RiceAllDay22/WirelessSensorNetwork/README.md

# Introduction to the Wireless Sensor Network Project
This repository contains the files utilized to create a low-cost wireless sensor network to identify, locate, and quantify CO2 sources within an area. The primary component of the network is the CO2 Sensor Node, for which there are two variants: the Arduino Version and the XBee Version. 

Both variants have the same essential function of collecting CO2 and wind data. The difference, however, is that the Arduino Version stores data within a microSD card, while the XBee Version sends data to a central hub. The XBee Version is the prominent hardware of this project.

An external repository called the [CSR_Arduino_Collection](https://github.com/RiceAllDay22/CSR_Arduino_Collection) is a complementary project that contains guides, codes, schematics, and datasheets for operating various sensors and modules, including the ones used in WSN. 

The overall WSN project is divided into three sections. [Section 1](https://github.com/RiceAllDay22/WirelessSensorNetwork/tree/master/Section1-Prototyping) focuses on the development of the Sensor Nodes. Next, [Section 2](https://github.com/RiceAllDay22/WirelessSensorNetwork/tree/master/Section2-Networking) establishes a wireless network between active nodes. Finally, [Section 3](https://github.com/RiceAllDay22/WirelessSensorNetwork/tree/master/Section3-Detecting) uses the collected data to identify and locate possible CO2 sources. Below are summaries and highlights of each section. 

# [Section 1: Developing the Sensor Nodes](https://github.com/RiceAllDay22/WirelessSensorNetwork/tree/master/Section1-Prototyping)
The Sensor Nodes are the backbone of WSN. Although there are two different variants: the Arduino Version and the XBee Version, they all consist of a CO2 sensor, a wind anemometer, and a time-keeping module.

[Arduino Version](https://github.com/jkub6/WirelessSensorNetwork/tree/master/Section1-ArduinoVersion) 
- Microcontroller is Arduino Nano
- Data saved on to a local microSD card
- Hardware is built on a solderless breadboard
- Code is compiled using Arduino IDE <br>

[XBee Version](https://github.com/jkub6/WirelessSensorNetwork/tree/master/Section2-XBeeVersion)
- Microcontroller is Digi XBee3
- Data transmitted to central hub
- Hardware is assembled on a custom printed-cicuit board
- Code is compiled using PyCharm

## Overview of Sensor Node
- [Arduino Version](https://github.com/RiceAllDay22/WirelessSensorNetwork/tree/master/Section1-Prototyping/SensorNode-ArduinoVersion)
- [XBee Version](https://github.com/RiceAllDay22/WirelessSensorNetwork/tree/master/Section1-Prototyping/SensorNode-XBeeVersion)

## Assessments of Individual Components
- [CU1106 CO2 Sensor](https://github.com/RiceAllDay22/WirelessSensorNetwork/tree/master/Section1-Prototyping/Assessment-CU1106) (not used for in current Node iterations)
- [SCD30 CO2 Sensor](https://github.com/RiceAllDay22/WirelessSensorNetwork/tree/master/Section1-Prototyping/Assessment-SCD30) (currently implemented in both Node versions)
- [DS3231 Timekeeping Module](https://github.com/RiceAllDay22/WirelessSensorNetwork/tree/master/Section1-Prototyping/Assessment-DS3231) (currently implemented in both Node versions)

## Power Evaluations
- [Power Usage of Nodes](https://github.com/RiceAllDay22/WirelessSensorNetwork/tree/master/Section1-Prototyping/Evaluation-PowerUsage)
- [Solar Requirement](https://github.com/RiceAllDay22/WirelessSensorNetwork/tree/master/Section1-Prototyping/Evaluation-PowerUsage)

# [Section 2: Establishing the Network](https://github.com/RiceAllDay22/WirelessSensorNetwork/tree/master/Section2-Networking)

The board is designed using Autodesk Eagle.

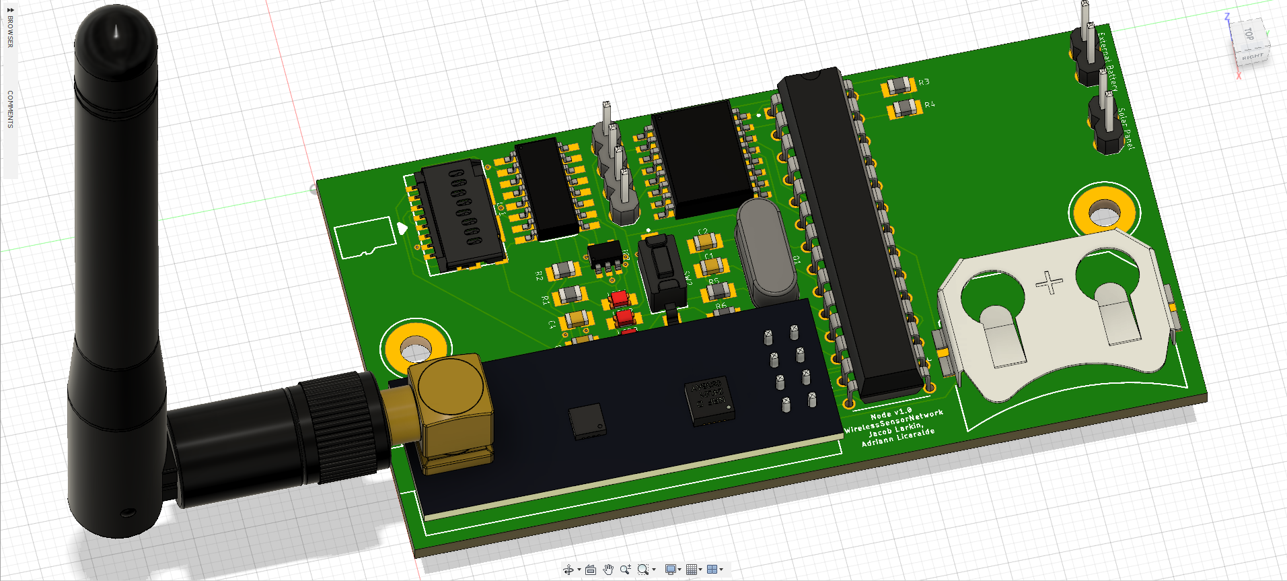
[picture p1: Collection/Node/Hardware/Node_step.png]
Node step
  
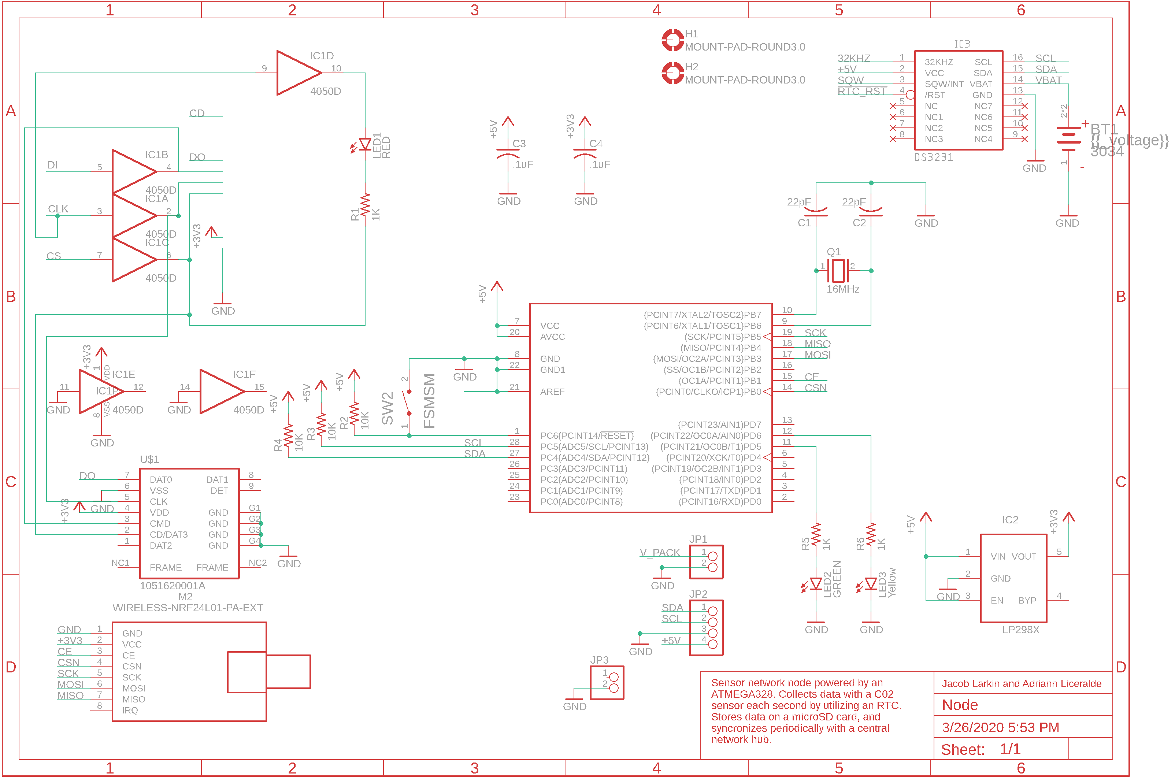
[picture p2: Collection/Node/Hardware/Node_sch.png]
Node schematic
  
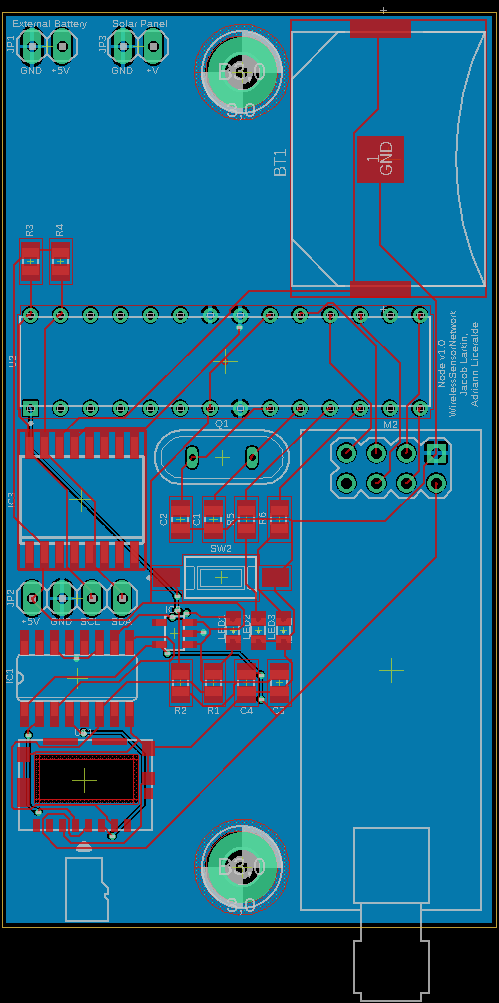
[picture p3: Collection/Node/Hardware/Node_brd.png]
Node board
  

# [Section 3: Locating Possible Carbon Sources](https://github.com/RiceAllDay22/WirelessSensorNetwork/tree/master/Section3-Detecting)
## Node Software
Code controlling individual nodes is compiled through the Arduino IDE.

Arduino Library Requirments:
 - RTClib
 - SdFat

resources:
[One Drive Resources Folder](https://uofutah-my.sharepoint.com/:f:/g/personal/u1010401_umail_utah_edu/Ekx1kX9h63tNoVFmzbePeowB8LEIOgGHBQhFq369KU12vQ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)

# Copyright and Contributors
Every hardware and every code in WirelessSensorNetwork and CSR_Arduino_Collection is given the Creative Commons License and the MIT License, respectively. Any content in the repository can be used and changed freely. The only requirement is that the original [license notice](https://github.com/jkub6/WirelessSensorNetwork/blob/master/LICENSE.md) is included in any copy of the software. 

The WirelessSensorNetwork project and the CSR_Arduino_Collection project are led by Adriann Liceralde under the leadership of Dr. Brian McPherson from the Carbon Science Research group at the University of Utah. Any questions, comments, or concerns are welcome to be sent to adriann8399@gmail.com.

Notable contributors to the project are Jacob Larkin, Charlie Leo, Tessa Bailey, Sean Taplin, and Andrew Winkelmann.

(c) Copyright 2022 Jacob Larkin and Adriann Liceralde
