RiceAllDay22/WirelessSensorNetwork/Data/ContinuousNodeSampling/V All/Report/PrimaryNode.png

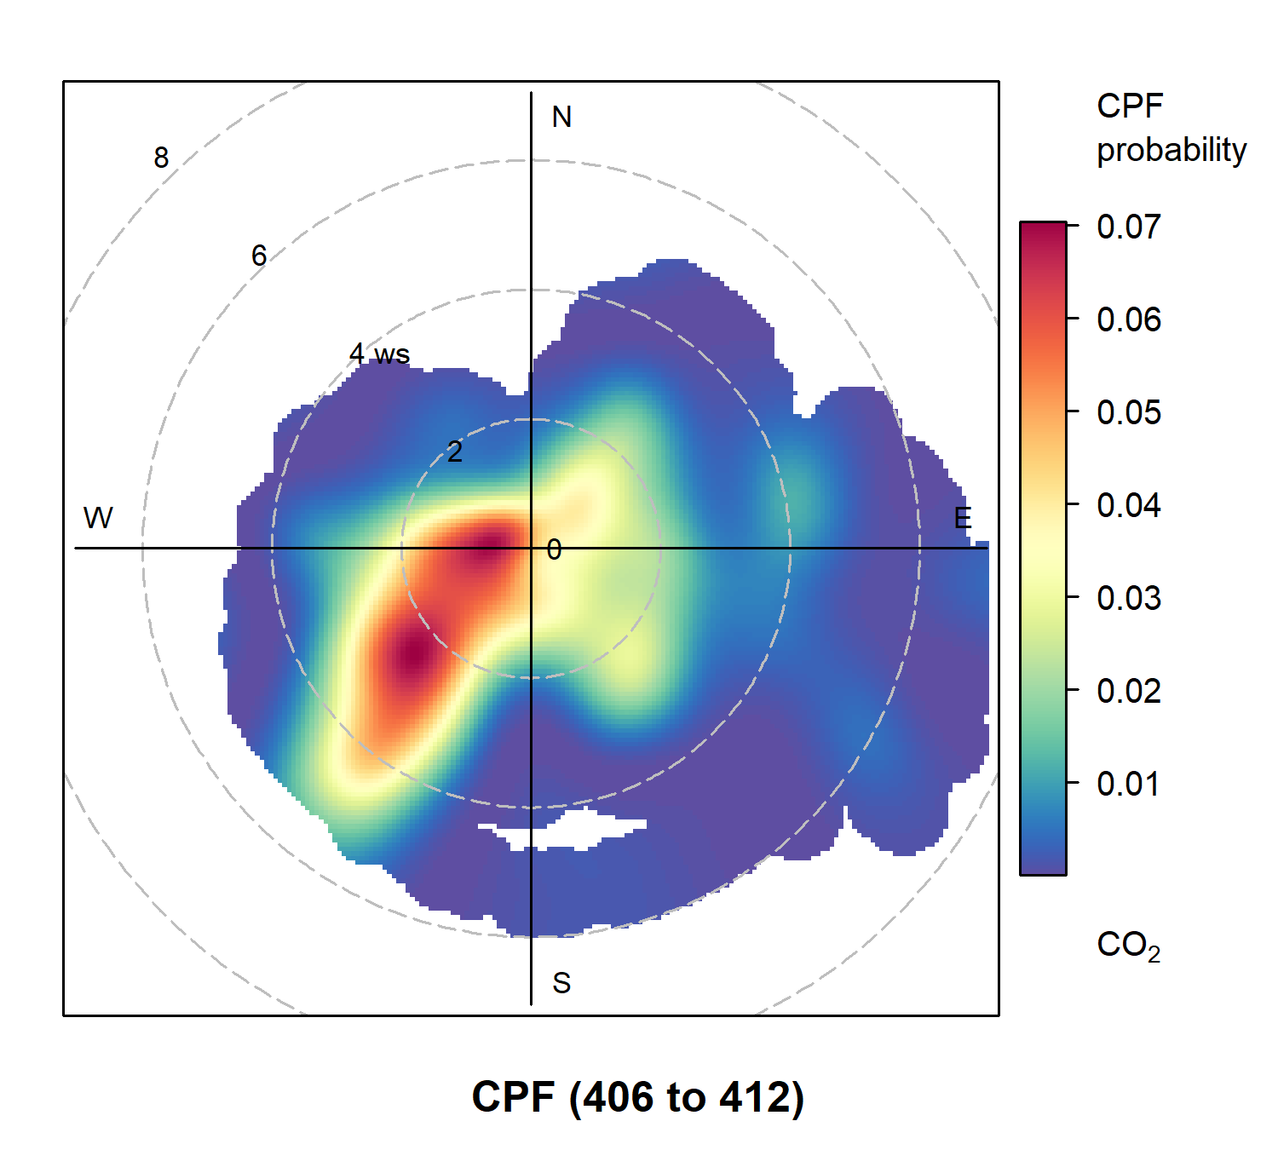
Data/ContinuousNodeSampling/V All/Report/PrimaryNode.png
