RiceAllDay22/WirelessSensorNetwork/Data/ContinuousNodeSampling/V All/Report/PrimaryNodeAdjusted.png

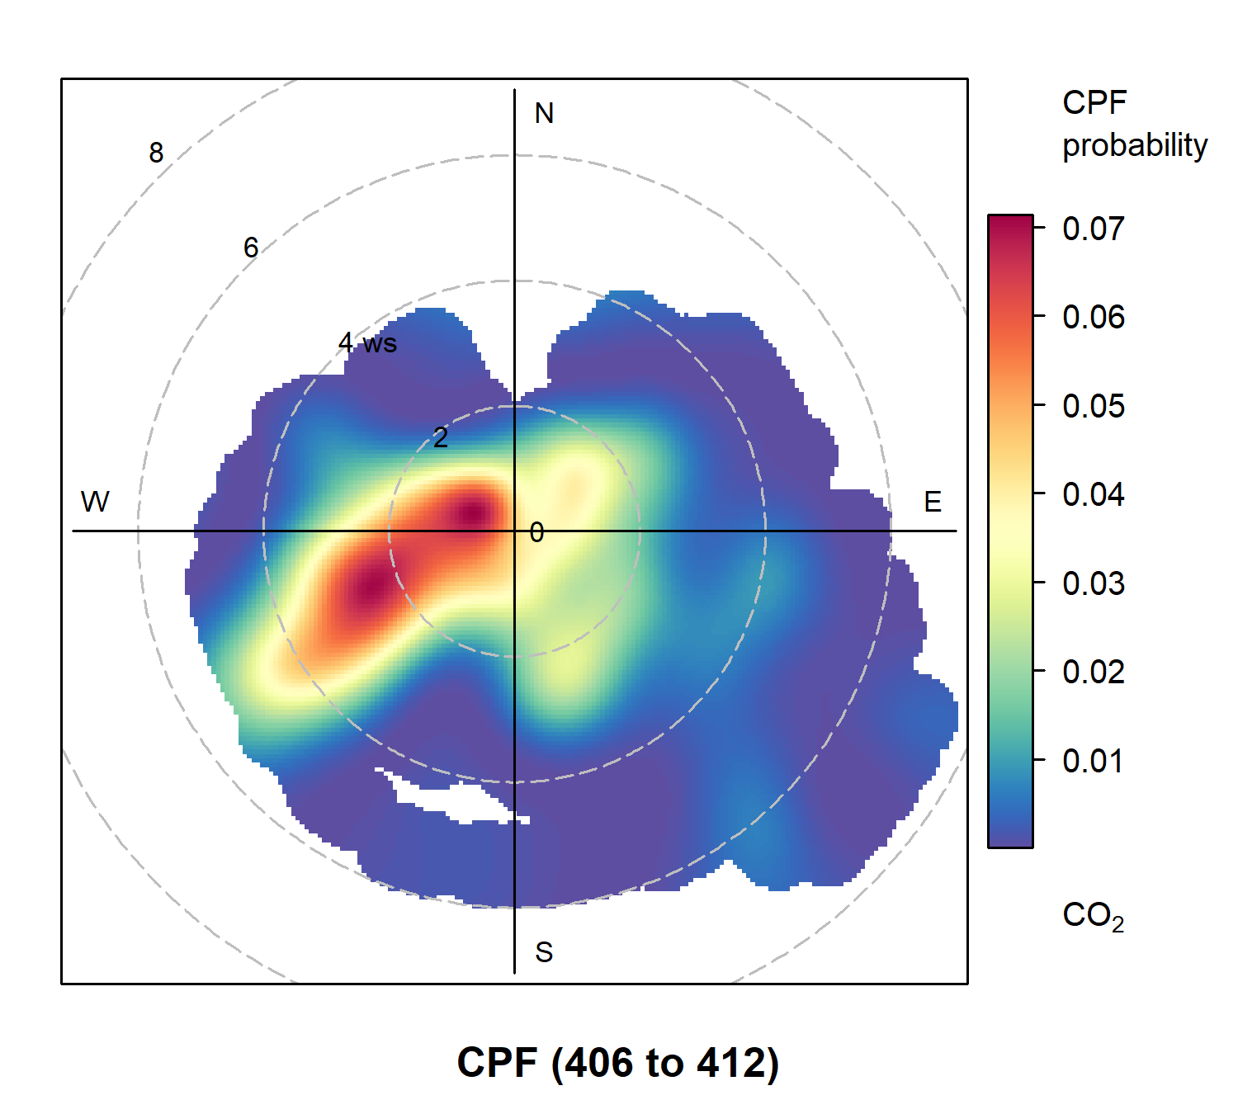
Data/ContinuousNodeSampling/V All/Report/PrimaryNodeAdjusted.png
