RiceAllDay22/WirelessSensorNetwork/Data/ContinuousNodeSampling/V All/Report/SecondaryNodeFirst.png

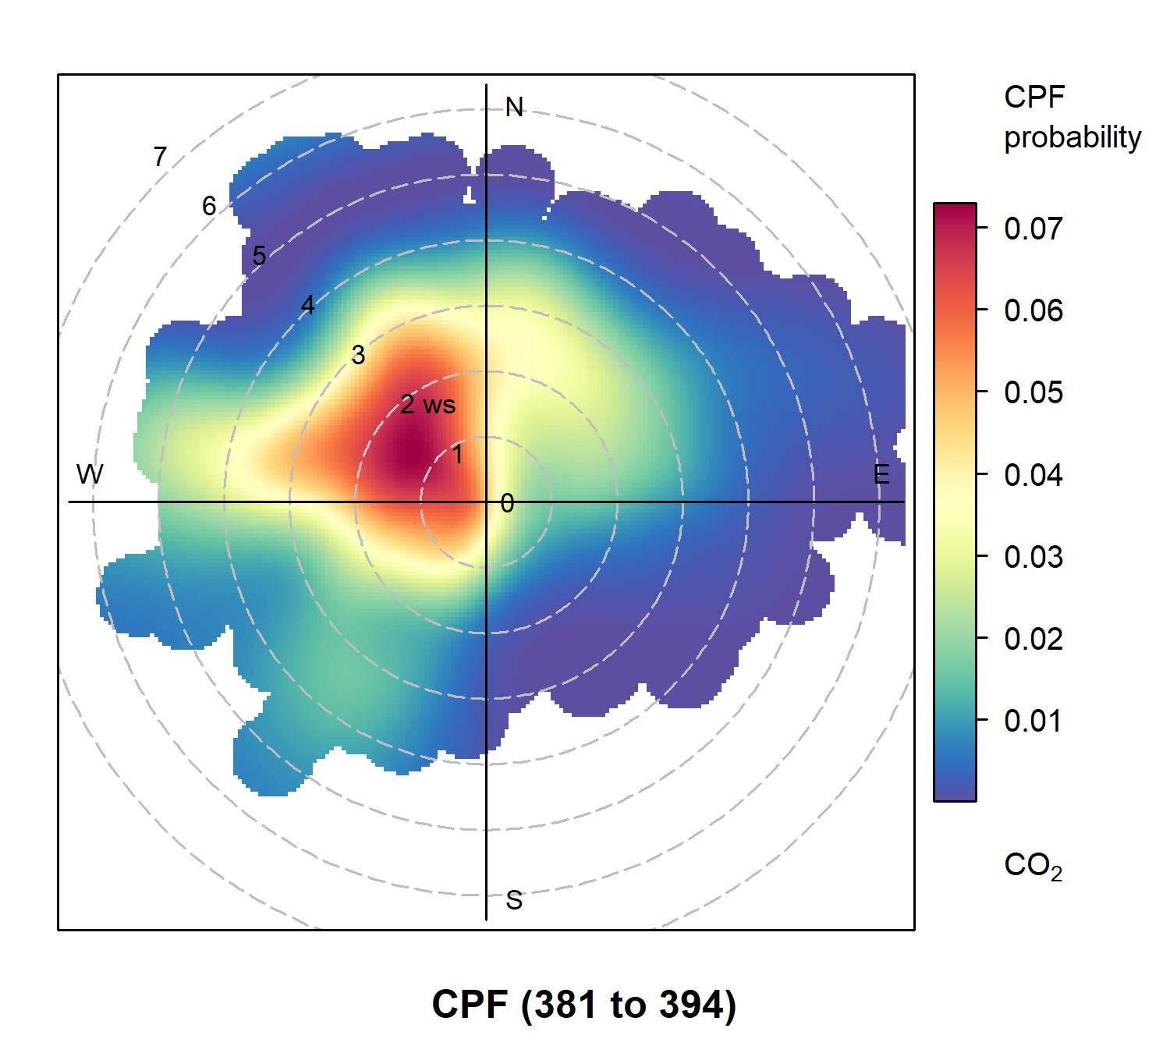
Data/ContinuousNodeSampling/V All/Report/SecondaryNodeFirst.png
