RiceAllDay22/WirelessSensorNetwork/Section1-Prototyping/Assessment-CU1106/MainFigures/Figure5-CU1106_Union_All.png

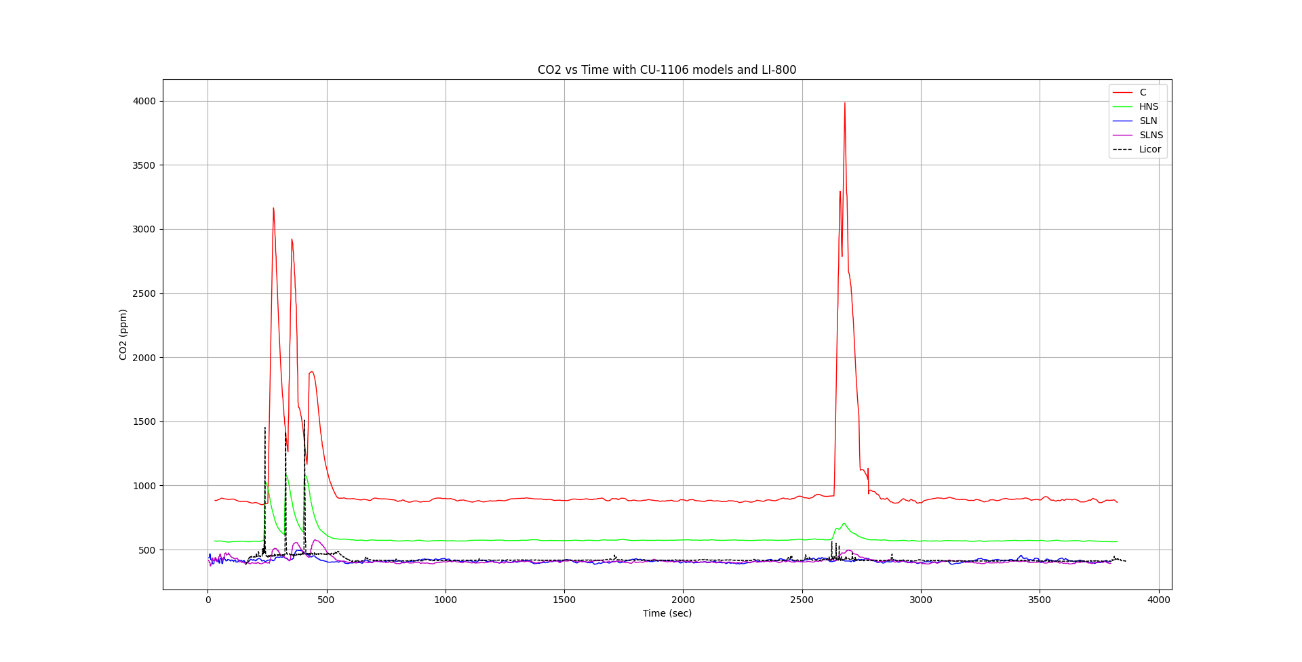
Section1-Prototyping/Assessment-CU1106/MainFigures/Figure5-CU1106_Union_All.png
