RiceAllDay22/WirelessSensorNetwork/Section1-Prototyping/Assessment-CU1106/MainFigures/Figure6-CU1106_Union_SL.png

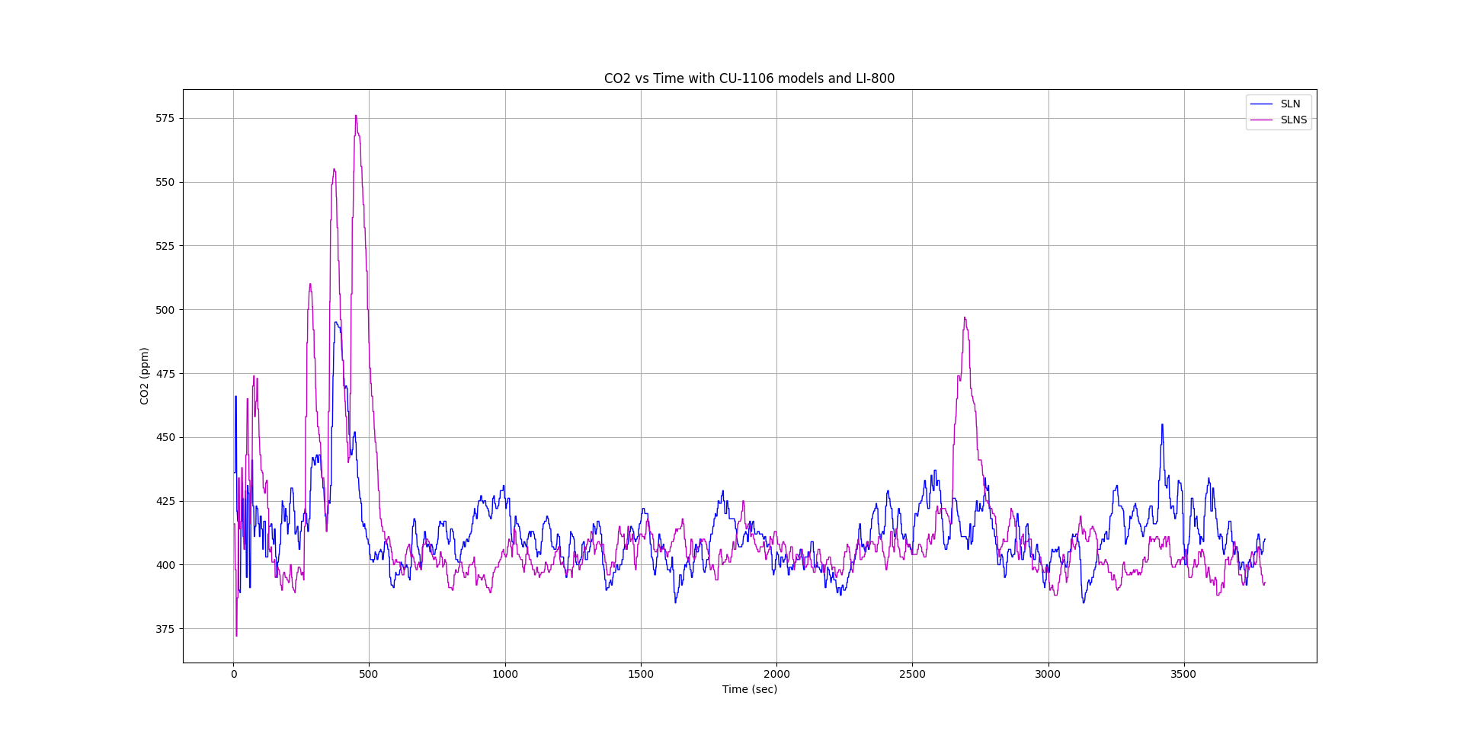
Section1-Prototyping/Assessment-CU1106/MainFigures/Figure6-CU1106_Union_SL.png
