RiceAllDay22/WirelessSensorNetwork/Section1-Prototyping/SensorNode-OutdoorDeployment/CO2HousingUnit/Housing.png

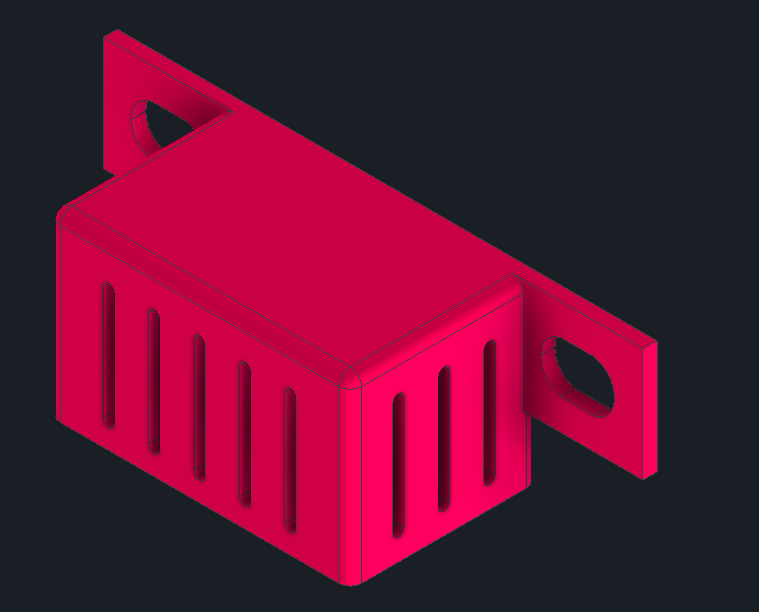
Section1-Prototyping/SensorNode-OutdoorDeployment/CO2HousingUnit/Housing.png
