RiceAllDay22/WirelessSensorNetwork/Section1-Prototyping/SensorNode-OutdoorDeployment/CO2HousingUnit/SCDHolderV4.stl

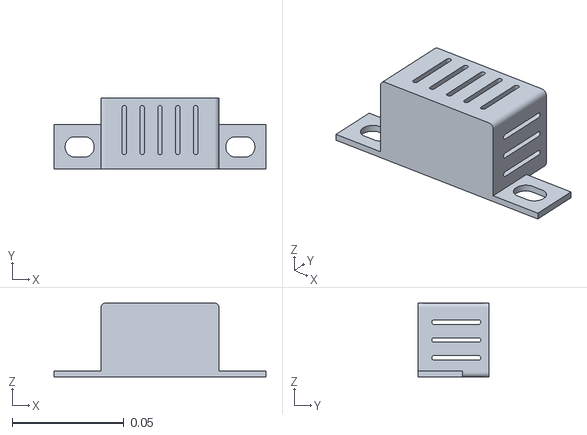
[picture p41: CAD file, 2022-03-23]
Section1-Prototyping/SensorNode-OutdoorDeployment/CO2HousingUnit/SCDHolderV4.stl
0.095 x 0.032 x 0.033
