RiceAllDay22/WirelessSensorNetwork/(list of files, cad)

Other CAD files:
Analysis/Collection/Node/Hardware/Node.f3d
Section1-Prototyping/SensorNode-OutdoorDeployment/CO2HousingUnit/SCDHolder3.ipt
Section1-Prototyping/SensorNode-OutdoorDeployment/CO2HousingUnit/SCDHolderExtender.ipt
UnusedFiles/JacobFiles/Hardware/Node.f3d
