RiceAllDay22/WirelessSensorNetwork/Section1-Prototyping/Evaluation-PowerUsage/PowerUsage-ArduinoNode.xlsx

Read times | Voltage(V) | Current(A) | Power (W)
6 | 4.983 | 0.0371 | 0.1848693
7 | 4.981 | 0.0371 | 0.1847951 | Statistics
8 | 4.981 | 0.0929 | 0.4627349 | Min V | 4.97
9 | 4.981 | 0.0929 | 0.4627349 | Max V | 4.99
10 | 4.981 | 0.0347 | 0.1728407 | Avg V | 4.98
11 | 4.981 | 0.0347 | 0.1728407 | Min mA | 29.2
12 | 4.981 | 0.0904 | 0.4502824 | Max mA | 92.9
13 | 4.982 | 0.0904 | 0.4503728 | Avg mA | 41.0
14 | 4.982 | 0.0345 | 0.171879 | Min mW | 145.27
15 | 4.981 | 0.0345 | 0.1718445 | Max mW | 462.7349
16 | 4.981 | 0.0902 | 0.4492862 | Avg mW | 204.1782737
17 | 4.982 | 0.0902 | 0.4493764 | Total h | 6
18 | 4.982 | 0.0345 | 0.171879 | Total s | 21600
19 | 4.981 | 0.0345 | 0.1718445
20 | 4.981 | 0.0898 | 0.4472938 | calc | mA * h = mAh
21 | 4.982 | 0.0898 | 0.4473836
22 | 4.982 | 0.0345 | 0.171879 | Power
23 | 4.982 | 0.0345 | 0.171879 | mAh calc | 245.8
24 | 4.982 | 0.0854 | 0.4254628 | mWh calc | 1225.069642
25 | 4.983 | 0.0854 | 0.4255482 | mAh USB | 243
26 | 4.983 | 0.0296 | 0.1474968 | mWh USB | 1211
27 | 4.981 | 0.0296 | 0.1474376 | mAh PC | 243
28 | 4.981 | 0.0852 | 0.4243812 | mWh PC | 1209
29 | 4.981 | 0.0852 | 0.4243812
30 | 4.981 | 0.0296 | 0.1474376 | Wh calc | 1.23
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
