RiceAllDay22/WirelessSensorNetwork/Section1-Prototyping/Evaluation-PowerUsage/PowerUsage-XBeeNode.xlsx

Read times | Voltage(V) | Current(A) | Power (W)
23 | 4.99 | 0.0094 | 0.046906
24 | 4.987 | 0.0094 | 0.0468778 | Statistics
25 | 4.987 | 0.0274 | 0.1366438 | Min V | 4.97
26 | 4.98 | 0.0274 | 0.136452 | Max V | 4.99
27 | 4.98 | 0.0221 | 0.110058 | Avg V | 4.99
28 | 4.987 | 0.0221 | 0.1102127 | Min mA | 9.00
29 | 4.987 | 0.0278 | 0.1386386 | Max mA | 80.90
30 | 4.981 | 0.0278 | 0.1384718 | Avg mA | 33.80
31 | 4.981 | 0.0228 | 0.1135668 | Min mW | 44.865
32 | 4.987 | 0.0228 | 0.1137036 | Max mW | 403.5292
33 | 4.987 | 0.027 | 0.134649 | Avg mW | 168.5297588
34 | 4.985 | 0.027 | 0.134595 | Total h | 6
35 | 4.985 | 0.0227 | 0.1131595 | Total s | 21600
36 | 4.987 | 0.0227 | 0.1132049
37 | 4.987 | 0.0272 | 0.1356464 | calc | mA * h = mAh
38 | 4.985 | 0.0272 | 0.135592
39 | 4.985 | 0.0225 | 0.1121625 | Power
40 | 4.987 | 0.0225 | 0.1122075 | mAh calc | 202.8
41 | 4.987 | 0.0461 | 0.2299007 | mWh calc | 1011.178553
42 | 4.985 | 0.0461 | 0.2298085 | mAh USB | 201
43 | 4.985 | 0.0221 | 0.1101685 | mWh USB | 1000
44 | 4.987 | 0.0221 | 0.1102127 | mAh PC | 201
45 | 4.987 | 0.0461 | 0.2299007 | mWh PC | 1000
46 | 4.985 | 0.0461 | 0.2298085
47 | 4.985 | 0.0221 | 0.1101685 | Wh calc | 1.011
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
