RiceAllDay22/WirelessSensorNetwork/Section1-Prototyping/SensorNode-ArduinoVersion/AssemblySteps/Step1.png

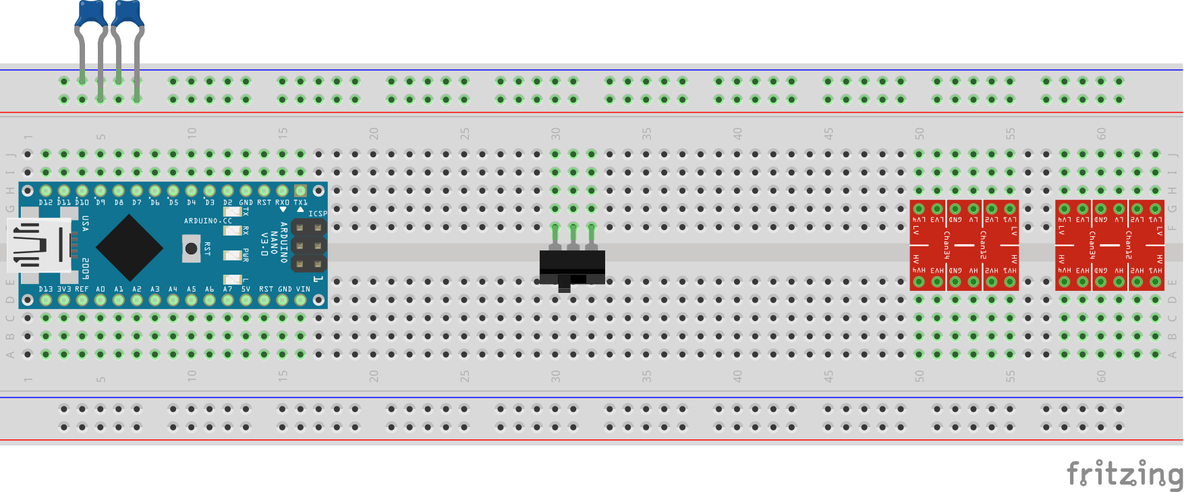
Section1-Prototyping/SensorNode-ArduinoVersion/AssemblySteps/Step1.png
