RiceAllDay22/WirelessSensorNetwork/Section1-Prototyping/SensorNode-ArduinoVersion/AssemblySteps/Step2.png

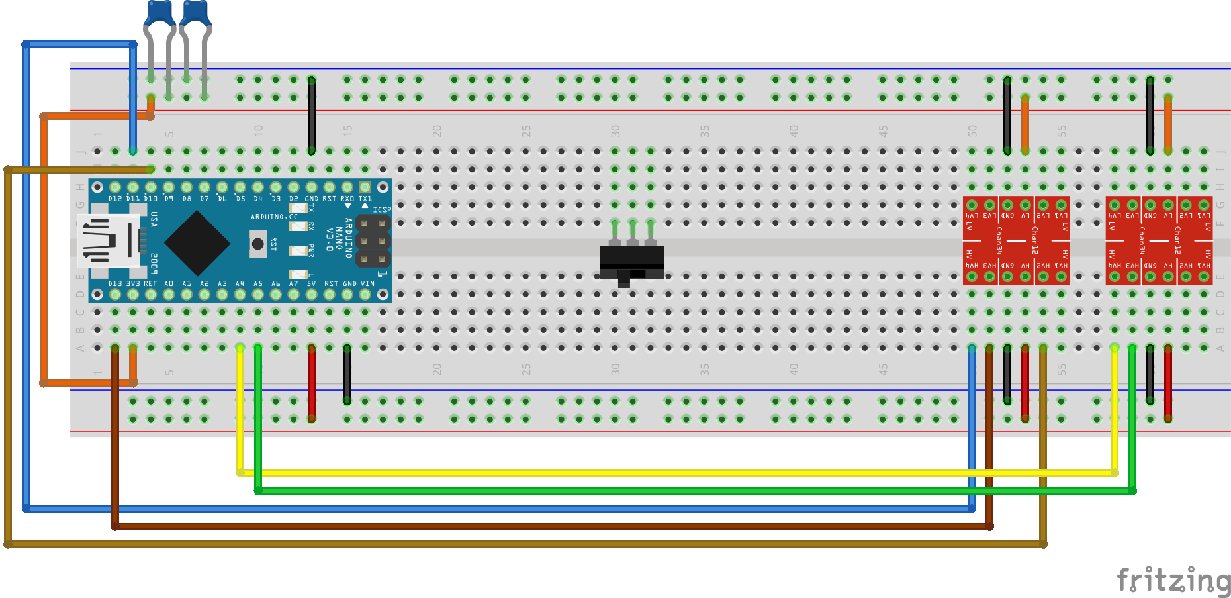
Section1-Prototyping/SensorNode-ArduinoVersion/AssemblySteps/Step2.png
