RiceAllDay22/WirelessSensorNetwork/Section1-Prototyping/SensorNode-ArduinoVersion/AssemblySteps/Step3.png

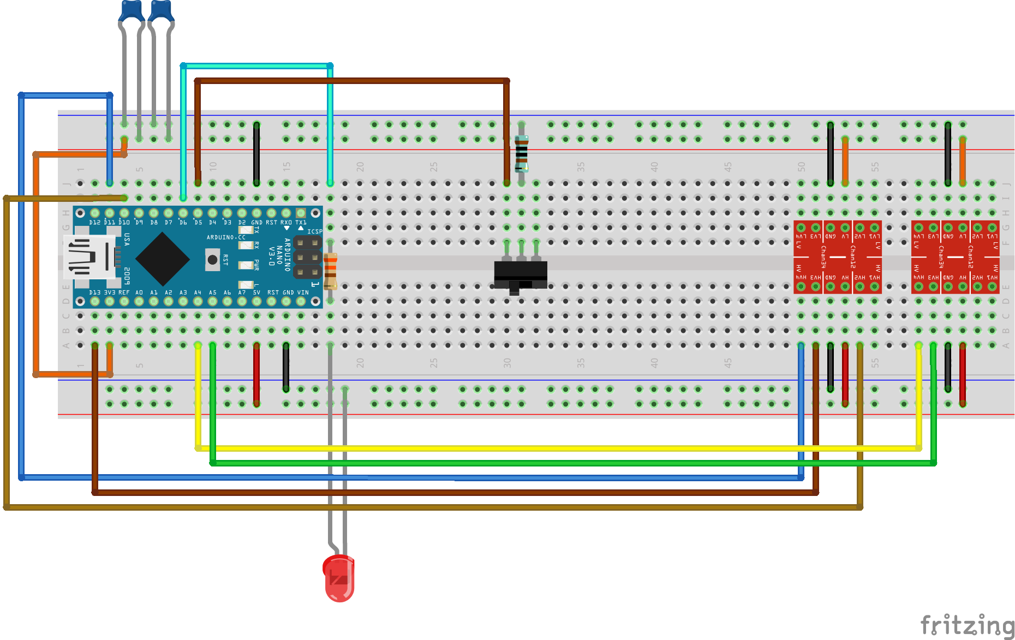
Section1-Prototyping/SensorNode-ArduinoVersion/AssemblySteps/Step3.png
