RiceAllDay22/WirelessSensorNetwork/Section1-Prototyping/SensorNode-ArduinoVersion/AssemblySteps/Step4.png

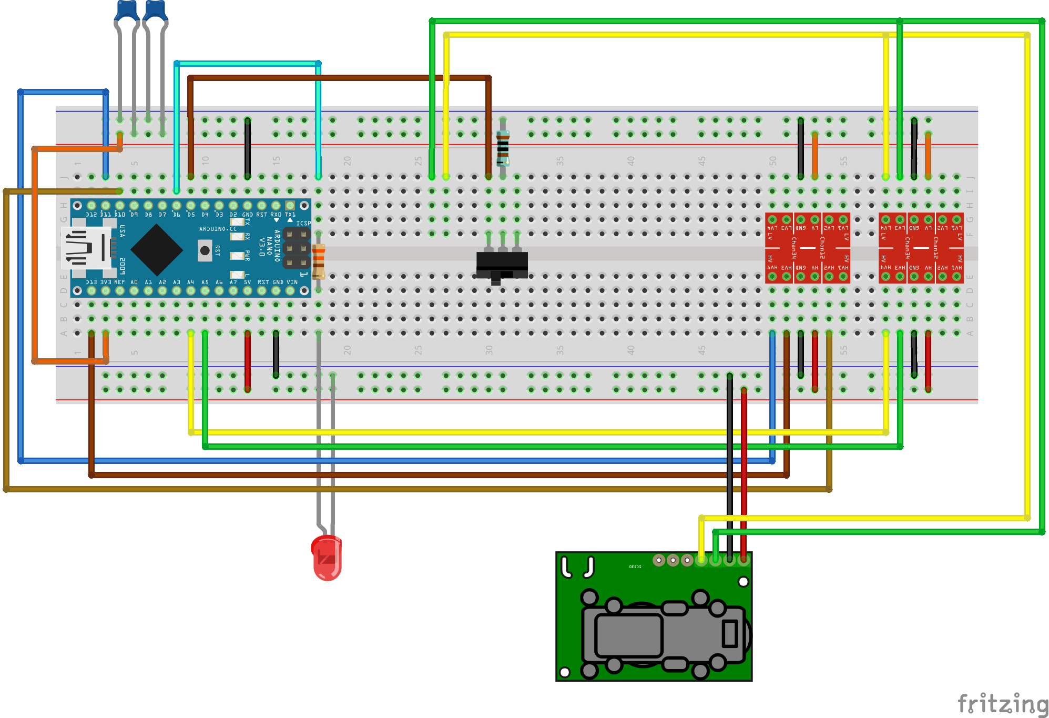
Section1-Prototyping/SensorNode-ArduinoVersion/AssemblySteps/Step4.png
