RiceAllDay22/WirelessSensorNetwork/Section1-Prototyping/SensorNode-ArduinoVersion/AssemblySteps/Step5.png

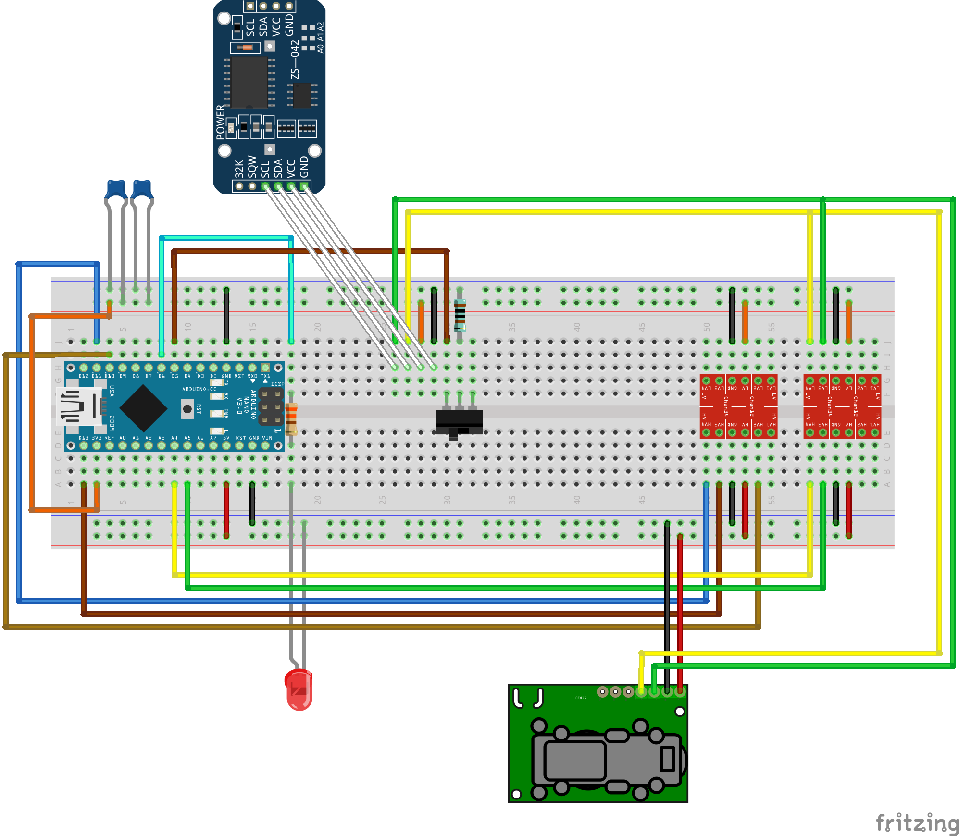
Section1-Prototyping/SensorNode-ArduinoVersion/AssemblySteps/Step5.png
