RiceAllDay22/WirelessSensorNetwork/Section1-Prototyping/SensorNode-ArduinoVersion/AssemblySteps/Step6.png

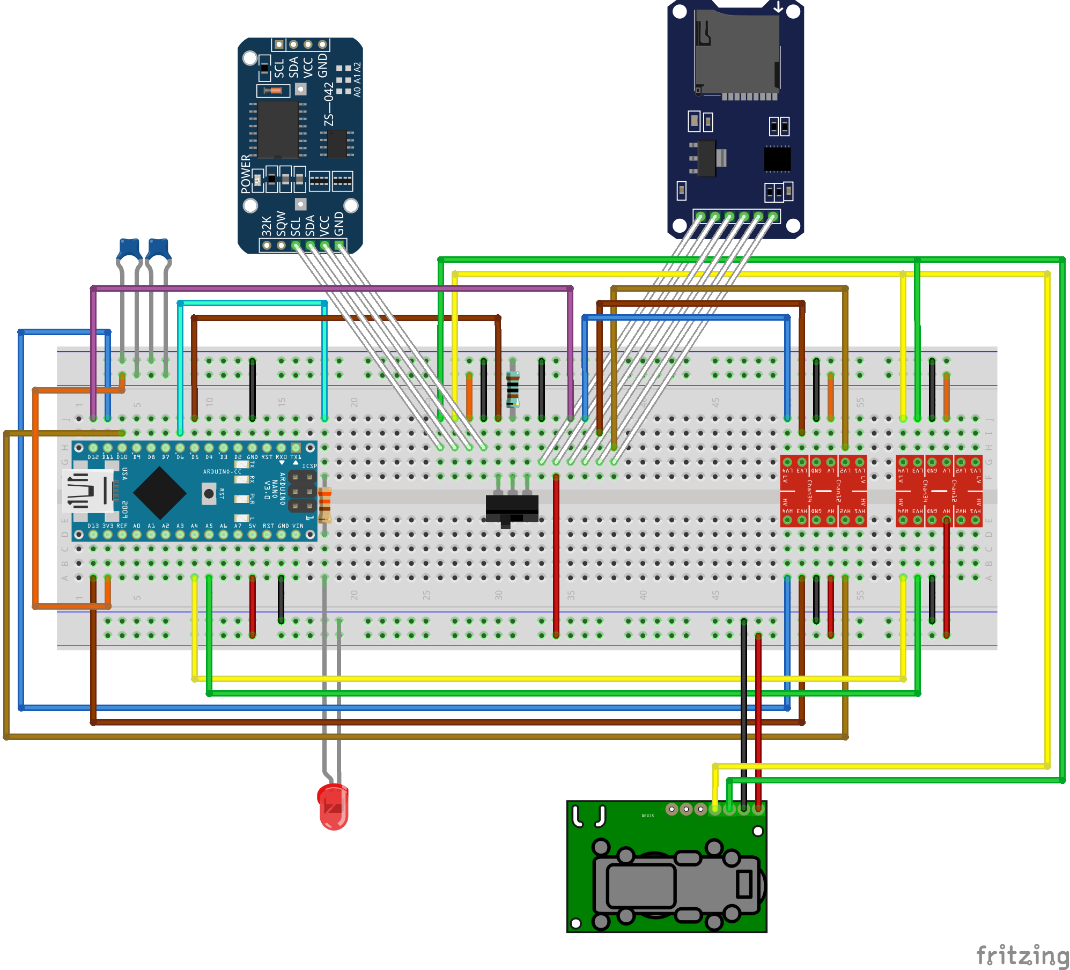
Section1-Prototyping/SensorNode-ArduinoVersion/AssemblySteps/Step6.png
