RiceAllDay22/WirelessSensorNetwork/Section3-Detecting/Analysis-FieldTest/Analysis-FieldTest.docx

Adriann Liceralde

Dr. Brian McPherson

Carbon Science Research at the University of Utah

Wireless Sensor Network Project

Last Updated June 19, 2022

Analysis of a Field Test Deployment of the Sensor Nodes

I. Introduction
