RiceAllDay22/WirelessSensorNetwork/Section1-Prototyping/Evaluation-SolarRequirement/Results/Trial3/PVGIS-5_OffgridPV_36.321_-100.966_NS_2.2Wp_23Wh_20_5Wh_35deg_0deg.pdf

# Performance of off-grid PV system

# PVGIS-5 estimates of solar electricity generation

# Provided inputs

Latitude/Longitude: | 36.321,-100.966
Horizon: | Calculated
Database used: | PVGIS-NSRDB
PV installed: | 2.2 Wp
Battery capacity: | 23 Wh
Cutoff limit: | 20 %

# Consumption per day: 5 Wh

Slope angle: | 35 °
Azimuth angle | 0 °

# Simulation outputs

# Percentage days with full battery: 85.69 % Percentage days with empty battery: 0.6 %

Average energy not captured: | 4.74 Wh
Average energy missing: | 1.86 Wh

# Outline of horizon at chosen location:

# Power production estimate for off-grid PV:

# Battery performance for off-grid PV system:

# Probability of battery charge state at the end of the day:

# Monthly average performance

Month | E_d | E_l | f_f | f_e
January | 4.9 | 2.8 | 71.3 | 0.6
February | 5.0 | 2.9 | 67.5 | 5.8
March | 5.0 | 4.4 | 89.4 | 0.0
April | 5.0 | 4.9 | 94.2 | 0.0
May | 5.0 | 5.0 | 95.6 | 0.0
June | 5.0 | 5.2 | 99.4 | 0.0
July | 5.0 | 5.0 | 99.1 | 0.0
August | 5.0 | 5.1 | 97.4 | 0.0
September | 5.0 | 4.7 | 94.5 | 0.0
October | 5.0 | 4.0 | 82.7 | 0.0
November | 5.0 | 3.2 | 80.6 | 0.0
December | 5.0 | 1.6 | 54.7 | 1.2

E_d: Average energy production per day [Wh/day].
E_l: Average energy not captured per day [Wh/day].
f_f: Percentage of days when battery became full [%].
f_e: Percentage of days when battery became empty [%].
Cs | Cb
20-28 | 1.0
28-36 | 0.0
36-44 | 0.0
44-52 | 1.0
52-60 | 1.0
60-68 | 1.0
68-76 | 3.0
76-84 | 4.0
84-92 | 44.0
92-100 | 45.0

Cs: Charge state at the end of each day [%].
Cb: Percentage of days with this charge state [%].

PVGIS ©European Union, 2001-2022.
Reproduction is authorised, provided the source is acknowledged, save where otherwise stated.

The European Commission maintains this website to enhance public access to information about its initiatives and European Union policies in general. Our goal is to keep this information timely and accurate. If errors are brought to our attention, we will try to correct them. However, the Commission accepts no responsibility or liability whatsoever with regard to the information on this site.

It is our goal to minimise disruption caused by technical errors. However, some data or information on this site may have been created or structured in files or formats that are not error-free and we cannot guarantee that our service will not be interrupted or otherwise affected by such problems. The Commission accepts no responsibility with regard to such problems incurred as a result of using this site or any linked external sites.

For more information, please visit https://ec.europa.eu/info/legal-notice_en

# Report generated on 2022/03/24
