RiceAllDay22/WirelessSensorNetwork/Section1-Prototyping/Evaluation-SolarRequirement/Results/Trial4/PVGIS-5_OffgridPV_36.321_-100.966_NS_2.2Wp_23Wh_20_4.1Wh_35deg_0deg.pdf

# Performance of off-grid PV system

# PVGIS-5 estimates of solar electricity generation

# Provided inputs

Latitude/Longitude: | 36.321,-100.966
Horizon: | Calculated
Database used: | PVGIS-NSRDB
PV installed: | 2.2 Wp
Battery capacity: | 23 Wh
Cutoff limit: | 20 %

# Consumption per day: 4.1 Wh

Slope angle: | 35 °
Azimuth angle | 0 °

# Simulation outputs

# Percentage days with full battery: 89.84 % Percentage days with empty battery: 0.17 %

Average energy not captured: | 5.51 Wh
Average energy missing: | 1.98 Wh

# Outline of horizon at chosen location:

# Power production estimate for off-grid PV:

# Battery performance for off-grid PV system:

# Probability of battery charge state at the end of the day:

# Monthly average performance

Month | E_d | E_l | f_f | f_e
January | 4.0 | 3.6 | 80.3 | 0.0
February | 4.1 | 3.7 | 74.3 | 2.3
March | 4.1 | 5.3 | 92.4 | 0.0
April | 4.1 | 5.8 | 96.7 | 0.0
May | 4.1 | 5.8 | 97.1 | 0.0
June | 4.1 | 6.1 | 99.4 | 0.0
July | 4.1 | 5.9 | 99.7 | 0.0
August | 4.1 | 6.0 | 98.0 | 0.0
September | 4.1 | 5.6 | 96.7 | 0.0
October | 4.1 | 4.9 | 87.4 | 0.0
November | 4.1 | 4.1 | 87.6 | 0.0
December | 4.1 | 2.5 | 67.1 | 0.0

E_d: Average energy production per day [Wh/day].
E_l: Average energy not captured per day [Wh/day].
f_f: Percentage of days when battery became full [%].
f_e: Percentage of days when battery became empty [%].
Cs | Cb
20-28 | 0.0
28-36 | 0.0
36-44 | 0.0
44-52 | 0.0
52-60 | 0.0
60-68 | 1.0
68-76 | 1.0
76-84 | 3.0
84-92 | 39.0
92-100 | 55.0

Cs: Charge state at the end of each day [%].
Cb: Percentage of days with this charge state [%].

PVGIS ©European Union, 2001-2022.
Reproduction is authorised, provided the source is acknowledged, save where otherwise stated.

The European Commission maintains this website to enhance public access to information about its initiatives and European Union policies in general. Our goal is to keep this information timely and accurate. If errors are brought to our attention, we will try to correct them. However, the Commission accepts no responsibility or liability whatsoever with regard to the information on this site.

It is our goal to minimise disruption caused by technical errors. However, some data or information on this site may have been created or structured in files or formats that are not error-free and we cannot guarantee that our service will not be interrupted or otherwise affected by such problems. The Commission accepts no responsibility with regard to such problems incurred as a result of using this site or any linked external sites.

For more information, please visit https://ec.europa.eu/info/legal-notice_en

# Report generated on 2022/03/24
