RiceAllDay22/WirelessSensorNetwork/Section1-Prototyping/Assessment-CU1106/Experiment1/Lab_All_Data.csv

C-sec | C-ppm | HNS-sec | HNS-ppm | SLN-sec | SLN-ppm | SLNS-sec | SLNS-ppm | Licor-sec | Licor-ppm
0 | 890 | 25 | 750 | 0 | 468 | 0 | 437 | 1279 | 1202.76
1 | 890 | 27 | 749 | 1 | 454 | 2 | 437 | 1280 | 817.62
3 | 888 | 28 | 749 | 3 | 454 | 3 | 467 | 1281 | 727.69
4 | 889 | 30 | 749 | 4 | 467 | 5 | 467 | 1282 | 819.57
6 | 890 | 32 | 748 | 6 | 467 | 6 | 467 | 1283 | 768.74
7 | 890 | 33 | 748 | 7 | 467 | 8 | 429 | 1284 | 665.13
9 | 891 | 35 | 748 | 9 | 465 | 9 | 429 | 1285 | 629.94
10 | 892 | 36 | 748 | 10 | 465 | 11 | 464 | 1286 | 616.25
12 | 893 | 38 | 748 | 12 | 505 | 12 | 464 | 1287 | 610.39
13 | 894 | 39 | 748 | 13 | 505 | 14 | 464 | 1288 | 612.34
15 | 894 | 41 | 748 | 15 | 505 | 15 | 456 | 1289 | 616.25
16 | 893 | 42 | 748 | 16 | 492 | 17 | 456 | 1290 | 626.03
18 | 892 | 44 | 748 | 18 | 492 | 18 | 456 | 1291 | 637.76
19 | 892 | 45 | 749 | 19 | 492 | 20 | 462 | 1292 | 643.62
21 | 892 | 47 | 749 | 21 | 478 | 21 | 462 | 1293 | 659.26
22 | 893 | 48 | 750 | 22 | 478 | 23 | 432 | 1294 | 672.95
24 | 820 | 50 | 751 | 24 | 465 | 24 | 432 | 1295 | 684.68
25 | 920 | 51 | 751 | 25 | 465 | 26 | 432 | 1296 | 690.54
27 | 920 | 53 | 752 | 27 | 465 | 27 | 472 | 1297 | 696.41
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
