RiceAllDay22/WirelessSensorNetwork/Section1-Prototyping/Assessment-CU1106/Experiment2/Union_All_Data.csv

C time | C ppm | H-NS time | H-NS ppm | SL-N time | SL-N ppm | SL-NS time | SL-NS ppm | Licor time | Licor ppm
31 | 1284 | 29 | 567 | 4 | 436 | 4 | 416 | 0 | 379.69
32 | 1283 | 31 | 567 | 5 | 436 | 5 | 416 | 1 | 385.56
34 | 1282 | 32 | 567 | 7 | 436 | 7 | 398 | 2 | 389.47
36 | 1283 | 34 | 567 | 8 | 466 | 8 | 398 | 3 | 391.42
37 | 1283 | 36 | 567 | 10 | 466 | 10 | 398 | 4 | 395.33
39 | 1284 | 37 | 566 | 11 | 466 | 11 | 372 | 5 | 395.33
40 | 1285 | 39 | 566 | 13 | 421 | 13 | 372 | 6 | 405.11
42 | 1287 | 40 | 566 | 14 | 421 | 14 | 387 | 7 | 409.02
43 | 1288 | 42 | 567 | 16 | 417 | 16 | 387 | 8 | 410.97
45 | 1290 | 43 | 567 | 17 | 417 | 17 | 387 | 9 | 418.79
46 | 1290 | 45 | 567 | 19 | 417 | 19 | 434 | 10 | 405.11
48 | 1292 | 46 | 567 | 20 | 390 | 20 | 434 | 11 | 422.7
49 | 1292 | 48 | 567 | 22 | 390 | 22 | 434 | 12 | 426.61
51 | 1293 | 49 | 567 | 23 | 390 | 23 | 414 | 13 | 428.57
52 | 1294 | 51 | 567 | 25 | 389 | 25 | 414 | 14 | 434.43
54 | 1297 | 52 | 567 | 26 | 389 | 26 | 414 | 15 | 440.3
55 | 1298 | 54 | 567 | 28 | 417 | 28 | 414 | 16 | 436.39
57 | 1300 | 55 | 567 | 30 | 417 | 29 | 414 | 17 | 444.21
58 | 1301 | 57 | 566 | 31 | 417 | 31 | 438 | 18 | 438.34
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
