RiceAllDay22/WirelessSensorNetwork/Section1-Prototyping/Assessment-DS3231/Experiment/HourlyDrift.xlsx

Hour | RTC1 | RTC2 | RTC3 | RTC4
0 | -0.4543677778 | -0.4563122222 | -0.4557566667 | -0.4610344444 |  |  |  |  | Day | RTC1 | RTC2 | RTC3 | RTC4 | RTC1 Rate | RTC2 Rate | RTC3 Rate | RTC4 Rate
1 | -0.5244980556 | -0.5292202778 | -0.5269980556 | -0.5439425 |  |  |  |  | 1 | 0.1679422222 | 0.1062755556 | 0.1454422222 | -0.1337244444
2 | -0.5924416667 | -0.5993861111 | -0.595775 | -0.6227194444 |  |  |  |  | 2 | 0.03320638889 | -0.08790472222 | -0.009849166667 | -0.5242936111 | -0.1347358333 | -0.1941802778 | -0.1552913889 | -0.3905691667
3 | -0.6244116667 | -0.6333005556 | -0.6285783333 | -0.6674672222 |  |  |  |  | 3 | 0.1027638889 | -0.07223611111 | 0.04304166667 | -0.7464027778 | 0.0695575 | 0.01566861111 | 0.05289083333 | -0.2221091667
4 | -0.6875419444 | -0.6989308333 | -0.6919863889 | -0.7400419444 |  |  |  |  | 4 | 0.05801194444 | -0.2075436111 | -0.03254361111 | -1.162265833 | -0.04475194444 | -0.1353075 | -0.07558527778 | -0.4158630556
5 | -0.7296419444 | -0.7438086111 | -0.7354752778 | -0.7976975 |  |  |  |  | 5 | -1.484365833 | -1.823254722 | -1.597699167 | -3.035199167 | -1.542377778 | -1.615711111 | -1.565155556 | -1.872933333
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
