RiceAllDay22/WirelessSensorNetwork/Section1-Prototyping/Assessment-SCD30/Experiment1/Lab_10-26_analysis.xlsx

PARTIAL LICOR |  | FULL LICOR |  |  | FULL SCD30 |  |  |  |  |  | CALIBRATION SCD30
LiCor UT | LiCor CO2 | LiCor UT | LiCor Sec | LiCor CO2 | SCD UT | SCD Sec | SCD 1 | SCD 2 | SCD 3 | SCD 4
1635305474 | 457.89 | 1635306276 | 0 | 457.89 | 1635306276 | 0 | 442 | 440 | 458 | 457 | 1635305982 | 467 | 466 | 474 | 534
1635305475 | 457.89 | 1635306277 | 1 | 459.85 | 1635306279 | 3 | 457 | 457 | 458 | 457 | 1635305985 | 463 | 465 | 473 | 534
1635305476 | 455.94 | 1635306278 | 2 | 459.85 | 1635306282 | 6 | 457 | 458 | 458 | 456 | 1635305988 | 463 | 464 | 472 | 532
1635305477 | 457.89 | 1635306279 | 3 | 455.94 | 1635306285 | 9 | 457 | 457 | 458 | 456 | 1635305991 | 462 | 465 | 472 | 531
1635305478 | 455.94 | 1635306280 | 4 | 457.89 | 1635306288 | 12 | 458 | 458 | 457 | 456 | 1635305994 | 459 | 463 | 471 | 533
1635305479 | 455.94 | 1635306281 | 5 | 455.94 | 1635306291 | 15 | 457 | 457 | 458 | 457 | 1635305997 | 457 | 462 | 471 | 533
1635305480 | 457.89 | 1635306282 | 6 | 459.85 | 1635306294 | 18 | 458 | 457 | 458 | 456 | 1635306000 | 458 | 461 | 472 | 534
1635305481 | 459.85 | 1635306283 | 7 | 457.89 | 1635306297 | 21 | 458 | 457 | 457 | 456 | 1635306003 | 456 | 461 | 471 | 535
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
