RiceAllDay22/WirelessSensorNetwork/Section1-Prototyping/Assessment-SCD30/Experiment1/Lab_10-26_raw.csv

Licor unixtime | LiCor time (Sec) | LiCor conc (ppm) | SCD unixtime | SCD time (sec) | SCD 1 (ppm) | SCD 2 (ppm) | SCD 3 (ppm) | SCD 4 (ppm)
1635306276 | 0 | 458 | 1635306276 | 0 | 442 | 440 | 458 | 457
1635306277 | 1 | 460 | 1635306279 | 3 | 457 | 457 | 458 | 457
1635306278 | 2 | 460 | 1635306282 | 6 | 457 | 458 | 458 | 456
1635306279 | 3 | 456 | 1635306285 | 9 | 457 | 457 | 458 | 456
1635306280 | 4 | 458 | 1635306288 | 12 | 458 | 458 | 457 | 456
1635306281 | 5 | 456 | 1635306291 | 15 | 457 | 457 | 458 | 457
1635306282 | 6 | 460 | 1635306294 | 18 | 458 | 457 | 458 | 456
1635306283 | 7 | 458 | 1635306297 | 21 | 458 | 457 | 457 | 456
1635306284 | 8 | 458 | 1635306300 | 24 | 458 | 456 | 457 | 457
1635306285 | 9 | 460 | 1635306303 | 27 | 457 | 456 | 457 | 457
1635306286 | 10 | 456 | 1635306306 | 30 | 458 | 456 | 457 | 457
1635306287 | 11 | 460 | 1635306309 | 33 | 458 | 455 | 457 | 458
1635306288 | 12 | 454 | 1635306312 | 36 | 458 | 455 | 457 | 458
1635306289 | 13 | 456 | 1635306315 | 39 | 458 | 455 | 457 | 459
1635306290 | 14 | 456 | 1635306318 | 42 | 457 | 455 | 457 | 459
1635306291 | 15 | 454 | 1635306321 | 45 | 458 | 454 | 457 | 460
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
