RiceAllDay22/WirelessSensorNetwork/Section1-Prototyping/Assessment-SCD30/Experiment2/11-01-21_Trial1.csv

Unixtime | Time (sec) | Licor (ppm) | SCD#1 (ppm) | SCD#2 (ppm) | SCD#3 (ppm) | SCD#4 (ppm)
1635820318 | 0 | 541 | 538 | 555 | 584 | 544
1635820321 | 3 | 547 | 536 | 553 | 583 | 542
1635820324 | 6 | 561 | 537 | 552 | 581 | 541
1635820327 | 9 | 545 | 535 | 550 | 580 | 540
1635820330 | 12 | 551 | 535 | 550 | 578 | 540
1635820333 | 15 | 563 | 534 | 546 | 577 | 539
1635820336 | 18 | 551 | 533 | 545 | 576 | 539
1635820339 | 21 | 559 | 533 | 544 | 576 | 537
1635820342 | 24 | 557 | 534 | 544 | 574 | 536
1635820345 | 27 | 584 | 533 | 543 | 573 | 534
1635820348 | 30 | 547 | 533 | 542 | 571 | 534
1635820351 | 33 | 557 | 532 | 542 | 573 | 534
1635820354 | 36 | 541 | 532 | 540 | 570 | 534
1635820357 | 39 | 545 | 531 | 540 | 571 | 535
1635820360 | 42 | 561 | 531 | 540 | 570 | 534
1635820363 | 45 | 541 | 532 | 540 | 569 | 534
1635820366 | 48 | 563 | 532 | 539 | 569 | 534
1635820369 | 51 | 540 | 531 | 539 | 567 | 535
1635820372 | 54 | 545 | 530 | 539 | 566 | 535
1635820375 | 57 | 561 | 529 | 538 | 566 | 534
1635820378 | 60 | 555 | 529 | 537 | 566 | 533
1635820381 | 63 | 559 | 529 | 537 | 565 | 533
1635820384 | 66 | 569 | 529 | 536 | 565 | 534
1635820387 | 69 | 540 | 529 | 535 | 564 | 534
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
