RiceAllDay22/WirelessSensorNetwork/Section1-Prototyping/Assessment-SCD30/Experiment2/11-01-21_Trial2.csv

Unixtime | Time (sec) | Licor (ppm) | SCD#1 (ppm) | SCD#2 (ppm) | SCD#3 (ppm) | SCD#4 (ppm)
1635822004 | 0 | 549 | 501 | 503 | 511 | 511
1635822007 | 3 | 538 | 501 | 502 | 511 | 511
1635822010 | 6 | 543 | 501 | 503 | 511 | 511
1635822013 | 9 | 522 | 501 | 502 | 512 | 511
1635822016 | 12 | 549 | 501 | 502 | 512 | 510
1635822019 | 15 | 532 | 500 | 503 | 510 | 511
1635822022 | 18 | 522 | 500 | 503 | 510 | 512
1635822025 | 21 | 524 | 500 | 502 | 509 | 512
1635822028 | 24 | 522 | 500 | 501 | 509 | 513
1635822031 | 27 | 526 | 501 | 501 | 509 | 513
1635822034 | 30 | 538 | 500 | 500 | 510 | 513
1635822037 | 33 | 520 | 500 | 500 | 511 | 515
1635822040 | 36 | 522 | 500 | 500 | 510 | 515
1635822043 | 39 | 524 | 501 | 500 | 510 | 515
1635822046 | 42 | 518 | 501 | 501 | 509 | 515
1635822049 | 45 | 547 | 501 | 501 | 510 | 515
1635822052 | 48 | 520 | 502 | 502 | 510 | 515
1635822055 | 51 | 534 | 502 | 502 | 510 | 515
1635822058 | 54 | 547 | 502 | 502 | 509 | 515
1635822061 | 57 | 530 | 501 | 502 | 509 | 515
1635822064 | 60 | 534 | 501 | 502 | 509 | 516
1635822067 | 63 | 536 | 501 | 502 | 509 | 516
1635822070 | 66 | 522 | 500 | 502 | 510 | 516
1635822073 | 69 | 536 | 500 | 502 | 510 | 516
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
