RiceAllDay22/WirelessSensorNetwork/Python/test/assets/node_data/invalid/5_nodes_short_csv_invalid_file/node_info.csv

UID | LONGITUDE | LATITUDE | ELEVATION
0 | -101 | 33 | 722
1 | -99 | 33 | 360
2 | -100 | 32 | 594
3 | -101 | 31 | 770
4 | -99 | 31 | 547
