RiceAllDay22/WirelessSensorNetwork/Python/test/assets/node_data/valid/100_nodes_pattern_csv/node_info.csv

UID | LONGITUDE | LATITUDE | ELEVATION
0 | -100.0 | 33.0 | 0
1 | -100.0 | 32.99 | 0
2 | -100.0 | 32.98 | 0
3 | -100.0 | 32.97 | 0
4 | -100.0 | 32.96 | 0
5 | -100.0 | 32.95 | 0
6 | -100.0 | 32.94 | 0
7 | -100.0 | 32.93 | 0
8 | -100.0 | 32.92 | 0
9 | -100.0 | 32.91 | 0
10 | -99.99 | 33.0 | 0
11 | -99.99 | 32.99 | 0
12 | -99.99 | 32.98 | 0
13 | -99.99 | 32.97 | 0
14 | -99.99 | 32.96 | 0
15 | -99.99 | 32.95 | 0
16 | -99.99 | 32.94 | 0
17 | -99.99 | 32.93 | 0
18 | -99.99 | 32.92 | 0
19 | -99.99 | 32.91 | 0
20 | -99.98 | 33.0 | 0
21 | -99.98 | 32.99 | 0
22 | -99.98 | 32.98 | 0
23 | -99.98 | 32.97 | 0
24 | -99.98 | 32.96 | 0
25 | -99.98 | 32.95 | 0
26 | -99.98 | 32.94 | 0
27 | -99.98 | 32.93 | 0
28 | -99.98 | 32.92 | 0
29 | -99.98 | 32.91 | 0
30 | -99.97 | 33.0 | 0
31 | -99.97 | 32.99 | 0
32 | -99.97 | 32.98 | 0
33 | -99.97 | 32.97 | 0
34 | -99.97 | 32.96 | 0
35 | -99.97 | 32.95 | 0
36 | -99.97 | 32.94 | 0
37 | -99.97 | 32.93 | 0
38 | -99.97 | 32.92 | 0
39 | -99.97 | 32.91 | 0
40 | -99.96 | 33.0 | 0
41 | -99.96 | 32.99 | 0
42 | -99.96 | 32.98 | 0
43 | -99.96 | 32.97 | 0
44 | -99.96 | 32.96 | 0
45 | -99.96 | 32.95 | 0
46 | -99.96 | 32.94 | 0
47 | -99.96 | 32.93 | 0
48 | -99.96 | 32.92 | 0
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
