RiceAllDay22/WirelessSensorNetwork/Python/test/assets/node_data/valid/3_nodes_unordered_csv/node_info.csv

UID | LONGITUDE | LATITUDE | ELEVATION
1 | -97.733330 | 30.266666 | 10
7 | 32.7767 | -96.7970 | 10
12 | 29.7604 | -95.3698 | 10
