RiceAllDay22/WirelessSensorNetwork/Python/test/assets/node_data/invalid/5_nodes_short_csv_invalid_file/0/2020-01-01--00.csv

UNIXTIME_FAKE | CO2
1577836800 | 1000
1577836801 | 1010
1577836802 | 1020
1577836803 | 1030
1577836804 | 1040
1577836805 | 1050
1577836806 | 1060
1577836807 | 1070
1577836808 | 1080
1577836809 | 1090
