RiceAllDay22/WirelessSensorNetwork/Python/test/assets/node_data/invalid/5_nodes_short_csv_invalid_file/2/2020-01-01--00.csv

UNIXTIME | CO2
1577836802 | 1120
1577836803 | 1130
1577836804 | 1140
1577836805 | 1150
1577836806 | 1160
1577836807 | 1170
1577836808 | 1180
1577836809 | 1190
1577836810 | 1200
1577836811 | 1210
