RiceAllDay22/WirelessSensorNetwork/Python/test/assets/node_data/invalid/5_nodes_short_csv_invalid_file/3/2020-01-01--00.csv

UNIXTIME | CO2
1577836803 | 1030
1577836804 | 1040
1577836805 | 1050
1577836806 | 1060
1577836807 | 1070
1577836808 | 1080
1577836809 | 1090
1577836810 | 1100
1577836811 | 1110
1577836812 | 1120
