RiceAllDay22/WirelessSensorNetwork/Python/test/assets/node_data/valid/100_nodes_pattern_csv/0/2020-01-01--00.csv

UNIXTIME | CO2
1577836800 | 1000
1577836801 | 999
1577836802 | 998
1577836803 | 997
1577836804 | 996
1577836805 | 995
1577836806 | 994
1577836807 | 993
1577836808 | 992
1577836809 | 991
1577836810 | 990
1577836811 | 989
1577836812 | 988
1577836813 | 987
1577836814 | 986
1577836815 | 985
1577836816 | 984
1577836817 | 983
1577836818 | 982
1577836819 | 981
1577836820 | 980
1577836821 | 979
1577836822 | 978
1577836823 | 977
1577836824 | 976
1577836825 | 975
1577836826 | 974
1577836827 | 973
1577836828 | 972
1577836829 | 971
1577836830 | 970
1577836831 | 969
1577836832 | 968
1577836833 | 967
1577836834 | 966
1577836835 | 965
1577836836 | 964
1577836837 | 963
1577836838 | 962
1577836839 | 961
1577836840 | 960
1577836841 | 959
1577836842 | 958
1577836843 | 957
1577836844 | 956
1577836845 | 955
1577836846 | 954
1577836847 | 953
1577836848 | 952
1577836849 | 951
1577836850 | 950
1577836851 | 949
1577836852 | 948
1577836853 | 947
1577836854 | 946
1577836855 | 945
1577836856 | 944
1577836857 | 943
1577836858 | 942
1577836859 | 941
1577836860 | 940
1577836861 | 939
1577836862 | 938
1577836863 | 937
1577836864 | 936
1577836865 | 935
1577836866 | 934
1577836867 | 933
1577836868 | 932
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
