RiceAllDay22/WirelessSensorNetwork/Python/test/assets/node_data/valid/100_nodes_pattern_csv/18/2020-01-01--00.csv

UNIXTIME | CO2
1577836800 | 1000
1577836801 | 998
1577836802 | 997
1577836803 | 996
1577836804 | 995
1577836805 | 994
1577836806 | 992
1577836807 | 991
1577836808 | 990
1577836809 | 989
1577836810 | 988
1577836811 | 987
1577836812 | 985
1577836813 | 984
1577836814 | 983
1577836815 | 982
1577836816 | 981
1577836817 | 980
1577836818 | 978
1577836819 | 977
1577836820 | 976
1577836821 | 975
1577836822 | 974
1577836823 | 973
1577836824 | 971
1577836825 | 970
1577836826 | 969
1577836827 | 968
1577836828 | 967
1577836829 | 966
1577836830 | 964
1577836831 | 963
1577836832 | 962
1577836833 | 961
1577836834 | 960
1577836835 | 959
1577836836 | 957
1577836837 | 956
1577836838 | 955
1577836839 | 954
1577836840 | 953
1577836841 | 952
1577836842 | 950
1577836843 | 949
1577836844 | 948
1577836845 | 947
1577836846 | 946
1577836847 | 945
1577836848 | 943
1577836849 | 942
1577836850 | 941
1577836851 | 940
1577836852 | 939
1577836853 | 937
1577836854 | 936
1577836855 | 935
1577836856 | 934
1577836857 | 933
1577836858 | 932
1577836859 | 930
1577836860 | 929
1577836861 | 928
1577836862 | 927
1577836863 | 926
1577836864 | 925
1577836865 | 923
1577836866 | 922
1577836867 | 921
1577836868 | 920
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
