RiceAllDay22/WirelessSensorNetwork/Python/test/assets/node_data/valid/100_nodes_pattern_csv/21/2020-01-01--00.csv

UNIXTIME | CO2
1577836800 | 1000
1577836801 | 998
1577836802 | 997
1577836803 | 996
1577836804 | 995
1577836805 | 994
1577836806 | 993
1577836807 | 992
1577836808 | 991
1577836809 | 990
1577836810 | 989
1577836811 | 988
1577836812 | 987
1577836813 | 986
1577836814 | 985
1577836815 | 984
1577836816 | 983
1577836817 | 981
1577836818 | 980
1577836819 | 979
1577836820 | 978
1577836821 | 977
1577836822 | 976
1577836823 | 975
1577836824 | 974
1577836825 | 973
1577836826 | 972
1577836827 | 971
1577836828 | 970
1577836829 | 969
1577836830 | 968
1577836831 | 967
1577836832 | 966
1577836833 | 965
1577836834 | 963
1577836835 | 962
1577836836 | 961
1577836837 | 960
1577836838 | 959
1577836839 | 958
1577836840 | 957
1577836841 | 956
1577836842 | 955
1577836843 | 954
1577836844 | 953
1577836845 | 952
1577836846 | 951
1577836847 | 950
1577836848 | 949
1577836849 | 948
1577836850 | 947
1577836851 | 945
1577836852 | 944
1577836853 | 943
1577836854 | 942
1577836855 | 941
1577836856 | 940
1577836857 | 939
1577836858 | 938
1577836859 | 937
1577836860 | 936
1577836861 | 935
1577836862 | 934
1577836863 | 933
1577836864 | 932
1577836865 | 931
1577836866 | 930
1577836867 | 928
1577836868 | 927
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
