RiceAllDay22/WirelessSensorNetwork/Python/test/assets/node_data/valid/100_nodes_pattern_csv/24/2020-01-01--00.csv

UNIXTIME | CO2
1577836800 | 1000
1577836801 | 998
1577836802 | 997
1577836803 | 996
1577836804 | 995
1577836805 | 994
1577836806 | 993
1577836807 | 992
1577836808 | 991
1577836809 | 989
1577836810 | 988
1577836811 | 987
1577836812 | 986
1577836813 | 985
1577836814 | 984
1577836815 | 983
1577836816 | 982
1577836817 | 980
1577836818 | 979
1577836819 | 978
1577836820 | 977
1577836821 | 976
1577836822 | 975
1577836823 | 974
1577836824 | 973
1577836825 | 972
1577836826 | 970
1577836827 | 969
1577836828 | 968
1577836829 | 967
1577836830 | 966
1577836831 | 965
1577836832 | 964
1577836833 | 963
1577836834 | 961
1577836835 | 960
1577836836 | 959
1577836837 | 958
1577836838 | 957
1577836839 | 956
1577836840 | 955
1577836841 | 954
1577836842 | 952
1577836843 | 951
1577836844 | 950
1577836845 | 949
1577836846 | 948
1577836847 | 947
1577836848 | 946
1577836849 | 945
1577836850 | 944
1577836851 | 942
1577836852 | 941
1577836853 | 940
1577836854 | 939
1577836855 | 938
1577836856 | 937
1577836857 | 936
1577836858 | 935
1577836859 | 933
1577836860 | 932
1577836861 | 931
1577836862 | 930
1577836863 | 929
1577836864 | 928
1577836865 | 927
1577836866 | 926
1577836867 | 924
1577836868 | 923
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
