RiceAllDay22/WirelessSensorNetwork/Python/test/assets/node_data/valid/100_nodes_pattern_csv/25/2020-01-01--00.csv

UNIXTIME | CO2
1577836800 | 1000
1577836801 | 998
1577836802 | 997
1577836803 | 996
1577836804 | 995
1577836805 | 994
1577836806 | 993
1577836807 | 992
1577836808 | 990
1577836809 | 989
1577836810 | 988
1577836811 | 987
1577836812 | 986
1577836813 | 985
1577836814 | 984
1577836815 | 982
1577836816 | 981
1577836817 | 980
1577836818 | 979
1577836819 | 978
1577836820 | 977
1577836821 | 976
1577836822 | 974
1577836823 | 973
1577836824 | 972
1577836825 | 971
1577836826 | 970
1577836827 | 969
1577836828 | 968
1577836829 | 966
1577836830 | 965
1577836831 | 964
1577836832 | 963
1577836833 | 962
1577836834 | 961
1577836835 | 960
1577836836 | 958
1577836837 | 957
1577836838 | 956
1577836839 | 955
1577836840 | 954
1577836841 | 953
1577836842 | 952
1577836843 | 950
1577836844 | 949
1577836845 | 948
1577836846 | 947
1577836847 | 946
1577836848 | 945
1577836849 | 944
1577836850 | 943
1577836851 | 941
1577836852 | 940
1577836853 | 939
1577836854 | 938
1577836855 | 937
1577836856 | 936
1577836857 | 935
1577836858 | 933
1577836859 | 932
1577836860 | 931
1577836861 | 930
1577836862 | 929
1577836863 | 928
1577836864 | 927
1577836865 | 925
1577836866 | 924
1577836867 | 923
1577836868 | 922
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
