RiceAllDay22/WirelessSensorNetwork/Python/test/assets/node_data/valid/100_nodes_pattern_csv/28/2020-01-01--00.csv

UNIXTIME | CO2
1577836800 | 1000
1577836801 | 998
1577836802 | 997
1577836803 | 996
1577836804 | 995
1577836805 | 994
1577836806 | 992
1577836807 | 991
1577836808 | 990
1577836809 | 989
1577836810 | 988
1577836811 | 986
1577836812 | 985
1577836813 | 984
1577836814 | 983
1577836815 | 982
1577836816 | 980
1577836817 | 979
1577836818 | 978
1577836819 | 977
1577836820 | 976
1577836821 | 974
1577836822 | 973
1577836823 | 972
1577836824 | 971
1577836825 | 970
1577836826 | 968
1577836827 | 967
1577836828 | 966
1577836829 | 965
1577836830 | 964
1577836831 | 962
1577836832 | 961
1577836833 | 960
1577836834 | 959
1577836835 | 958
1577836836 | 956
1577836837 | 955
1577836838 | 954
1577836839 | 953
1577836840 | 952
1577836841 | 950
1577836842 | 949
1577836843 | 948
1577836844 | 947
1577836845 | 946
1577836846 | 944
1577836847 | 943
1577836848 | 942
1577836849 | 941
1577836850 | 940
1577836851 | 938
1577836852 | 937
1577836853 | 936
1577836854 | 935
1577836855 | 934
1577836856 | 932
1577836857 | 931
1577836858 | 930
1577836859 | 929
1577836860 | 928
1577836861 | 926
1577836862 | 925
1577836863 | 924
1577836864 | 923
1577836865 | 922
1577836866 | 920
1577836867 | 919
1577836868 | 918
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
