RiceAllDay22/WirelessSensorNetwork/Python/test/assets/node_data/valid/100_nodes_pattern_csv/46/2020-01-01--00.csv

UNIXTIME | CO2
1577836800 | 1000
1577836801 | 998
1577836802 | 997
1577836803 | 996
1577836804 | 994
1577836805 | 993
1577836806 | 992
1577836807 | 991
1577836808 | 989
1577836809 | 988
1577836810 | 987
1577836811 | 985
1577836812 | 984
1577836813 | 983
1577836814 | 982
1577836815 | 980
1577836816 | 979
1577836817 | 978
1577836818 | 976
1577836819 | 975
1577836820 | 974
1577836821 | 973
1577836822 | 971
1577836823 | 970
1577836824 | 969
1577836825 | 968
1577836826 | 966
1577836827 | 965
1577836828 | 964
1577836829 | 962
1577836830 | 961
1577836831 | 960
1577836832 | 959
1577836833 | 957
1577836834 | 956
1577836835 | 955
1577836836 | 953
1577836837 | 952
1577836838 | 951
1577836839 | 950
1577836840 | 948
1577836841 | 947
1577836842 | 946
1577836843 | 944
1577836844 | 943
1577836845 | 942
1577836846 | 941
1577836847 | 939
1577836848 | 938
1577836849 | 937
1577836850 | 936
1577836851 | 934
1577836852 | 933
1577836853 | 932
1577836854 | 930
1577836855 | 929
1577836856 | 928
1577836857 | 927
1577836858 | 925
1577836859 | 924
1577836860 | 923
1577836861 | 921
1577836862 | 920
1577836863 | 919
1577836864 | 918
1577836865 | 916
1577836866 | 915
1577836867 | 914
1577836868 | 912
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
