RiceAllDay22/WirelessSensorNetwork/Section1-Prototyping/Assessment-CU1106/MainFigures/Figure4_CU1106_Lab_Experiment_Adjusted.png

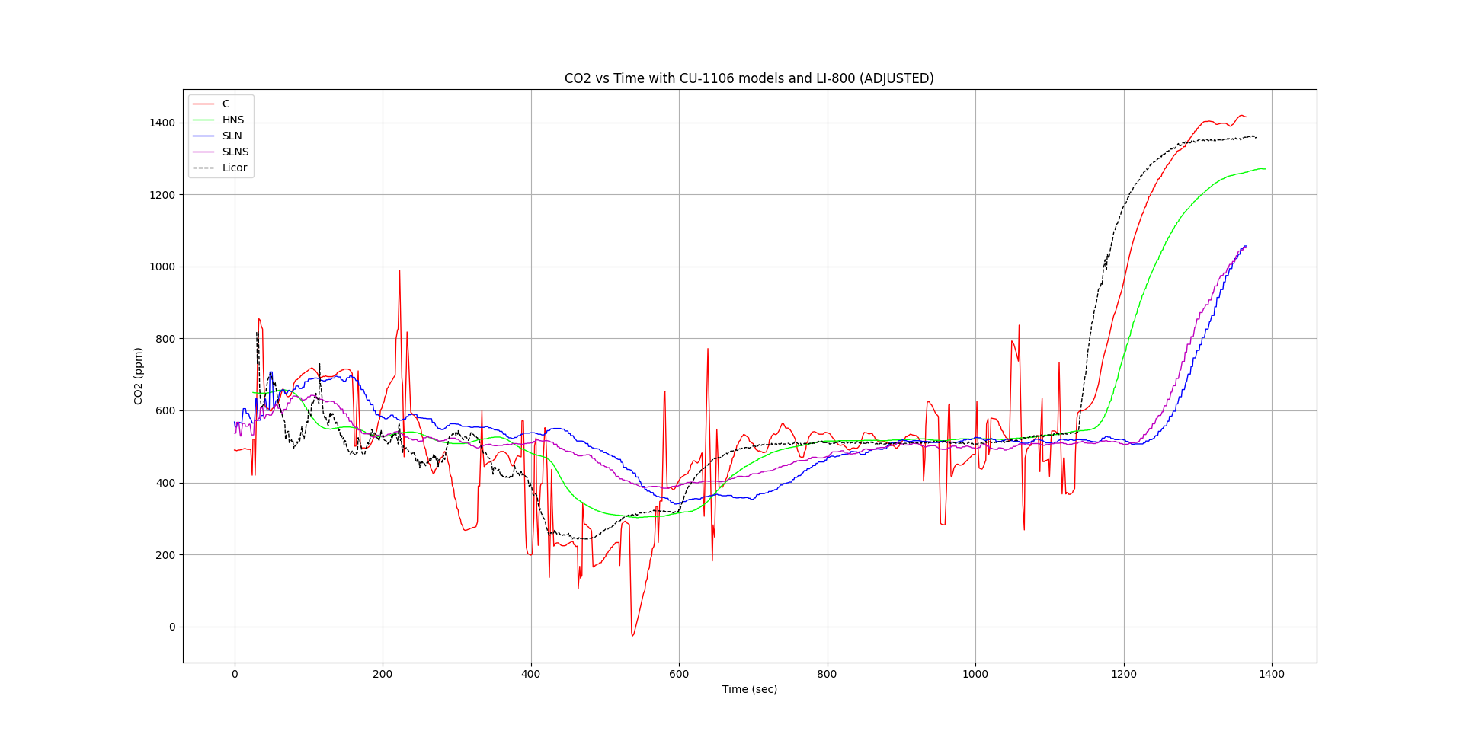
Section1-Prototyping/Assessment-CU1106/MainFigures/Figure4_CU1106_Lab_Experiment_Adjusted.png
