RiceAllDay22/WirelessSensorNetwork/Section1-Prototyping/Assessment-DS3231/Experiment/HourlyDriftAdjusted.png

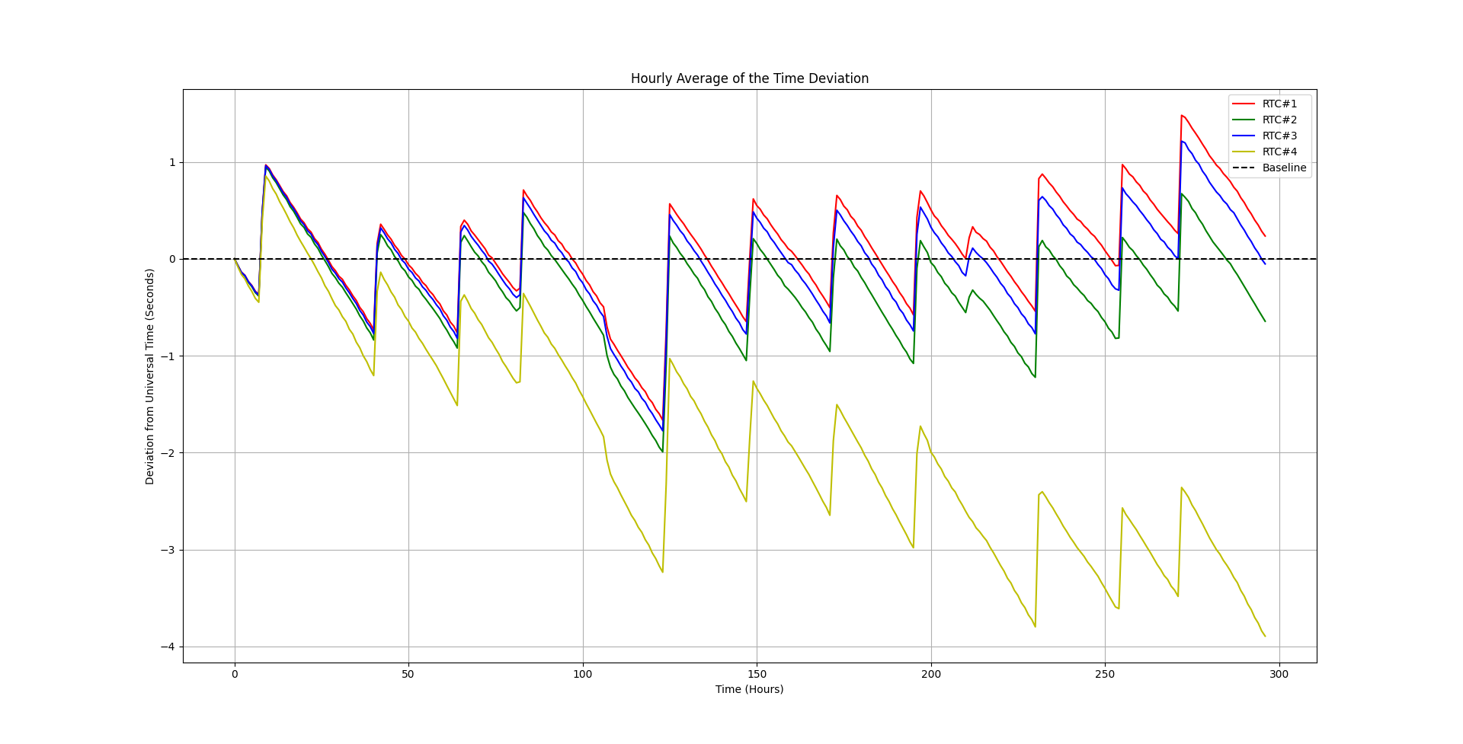
Section1-Prototyping/Assessment-DS3231/Experiment/HourlyDriftAdjusted.png
