RiceAllDay22/WirelessSensorNetwork/Section1-Prototyping/Assessment-SCD30/Experiment1/10-26_Figure_2.png

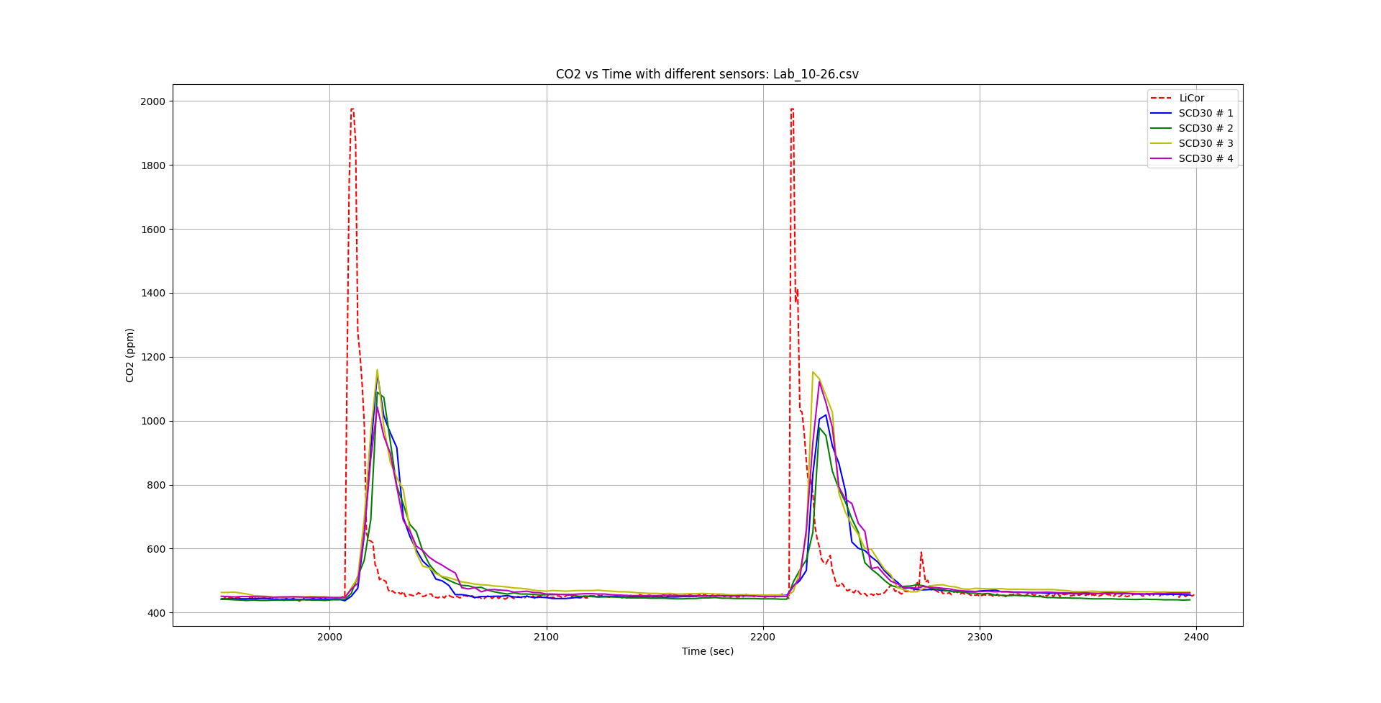
Section1-Prototyping/Assessment-SCD30/Experiment1/10-26_Figure_2.png
