RiceAllDay22/WirelessSensorNetwork/Section1-Prototyping/Assessment-SCD30/Experiment2/11-01b_full.png

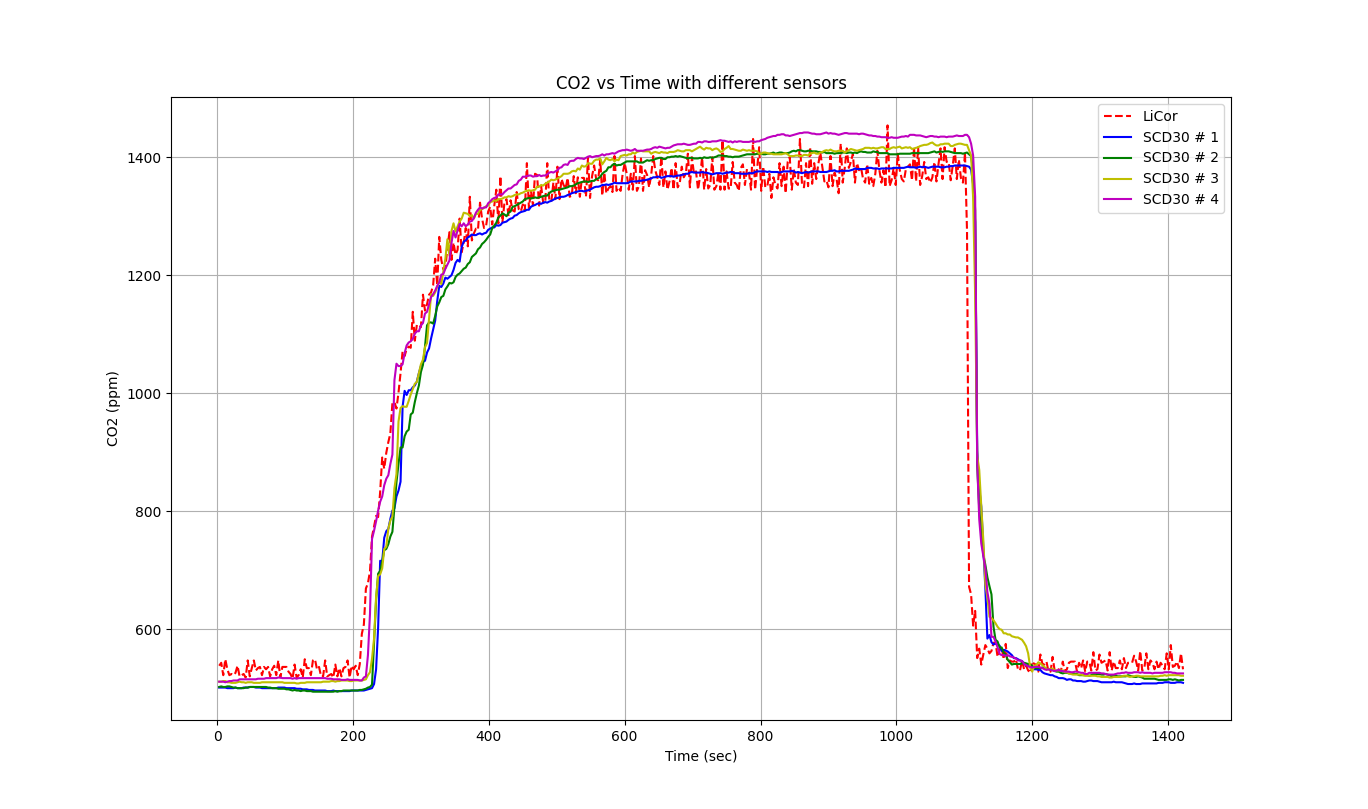
Section1-Prototyping/Assessment-SCD30/Experiment2/11-01b_full.png
