RiceAllDay22/WirelessSensorNetwork/Section1-Prototyping/Evaluation-SolarRequirement/Results/Trial1/PVbattery_40.765_-111.846_undefined_2.2Wp_23Wh_20_5.0Wh_35deg_0deg_L.png

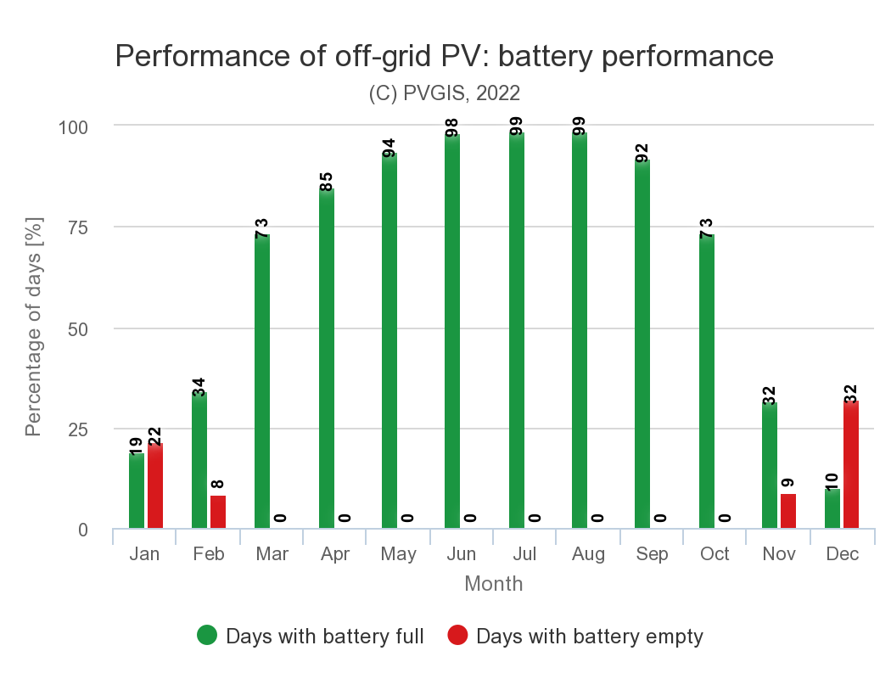
Section1-Prototyping/Evaluation-SolarRequirement/Results/Trial1/PVbattery_40.765_-111.846_undefined_2.2Wp_23Wh_20_5.0Wh_35deg_0deg_L.png
