RiceAllDay22/WirelessSensorNetwork/Section1-Prototyping/Evaluation-SolarRequirement/Results/Trial2/PVoffgrid_40.765_-111.846_undefined_2.2Wp_23Wh_20_4.1Wh_35deg_0deg_L.png

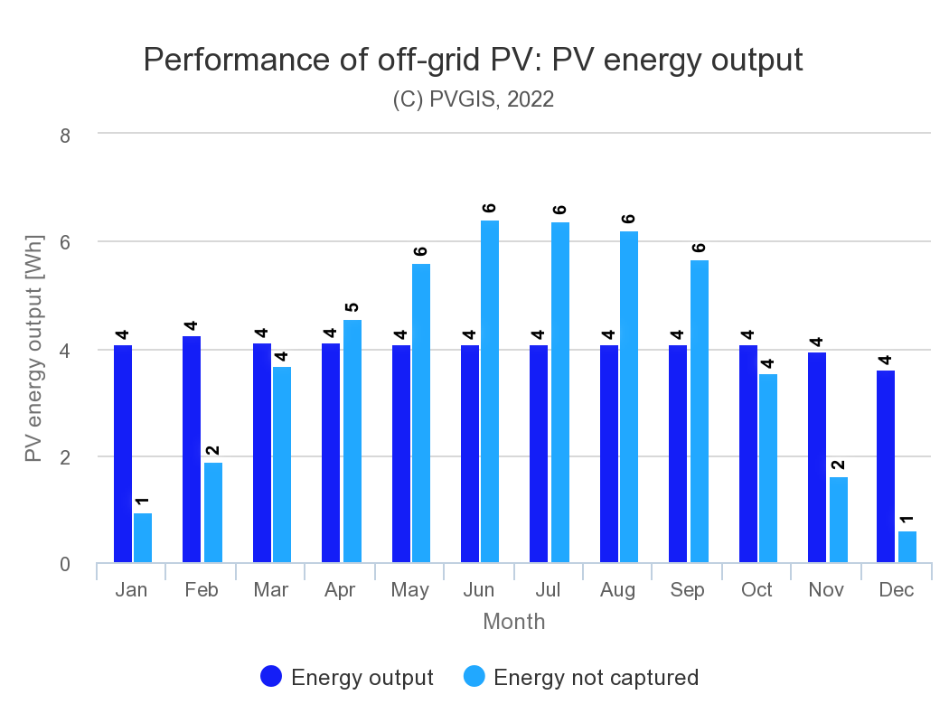
Section1-Prototyping/Evaluation-SolarRequirement/Results/Trial2/PVoffgrid_40.765_-111.846_undefined_2.2Wp_23Wh_20_4.1Wh_35deg_0deg_L.png
