RiceAllDay22/WirelessSensorNetwork/Section1-Prototyping/Evaluation-SolarRequirement/Results/Trial3/PVbattery_36.321_-100.966_undefined_2.2Wp_23Wh_20_5Wh_35deg_0deg_L.png

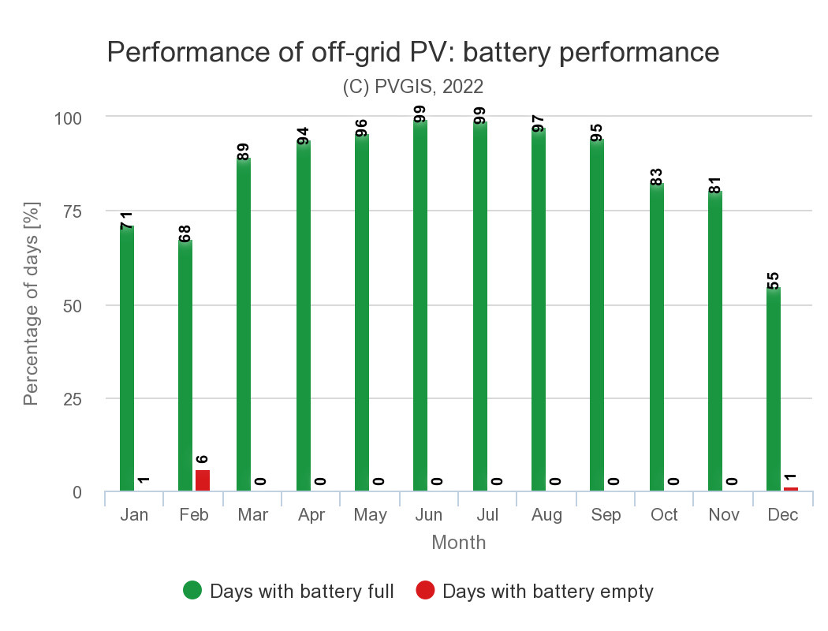
Section1-Prototyping/Evaluation-SolarRequirement/Results/Trial3/PVbattery_36.321_-100.966_undefined_2.2Wp_23Wh_20_5Wh_35deg_0deg_L.png
