RiceAllDay22/WirelessSensorNetwork/Section1-Prototyping/SensorNode-ArduinoVersion/Schematics/ArduinoVersion_Breadboard.pdf

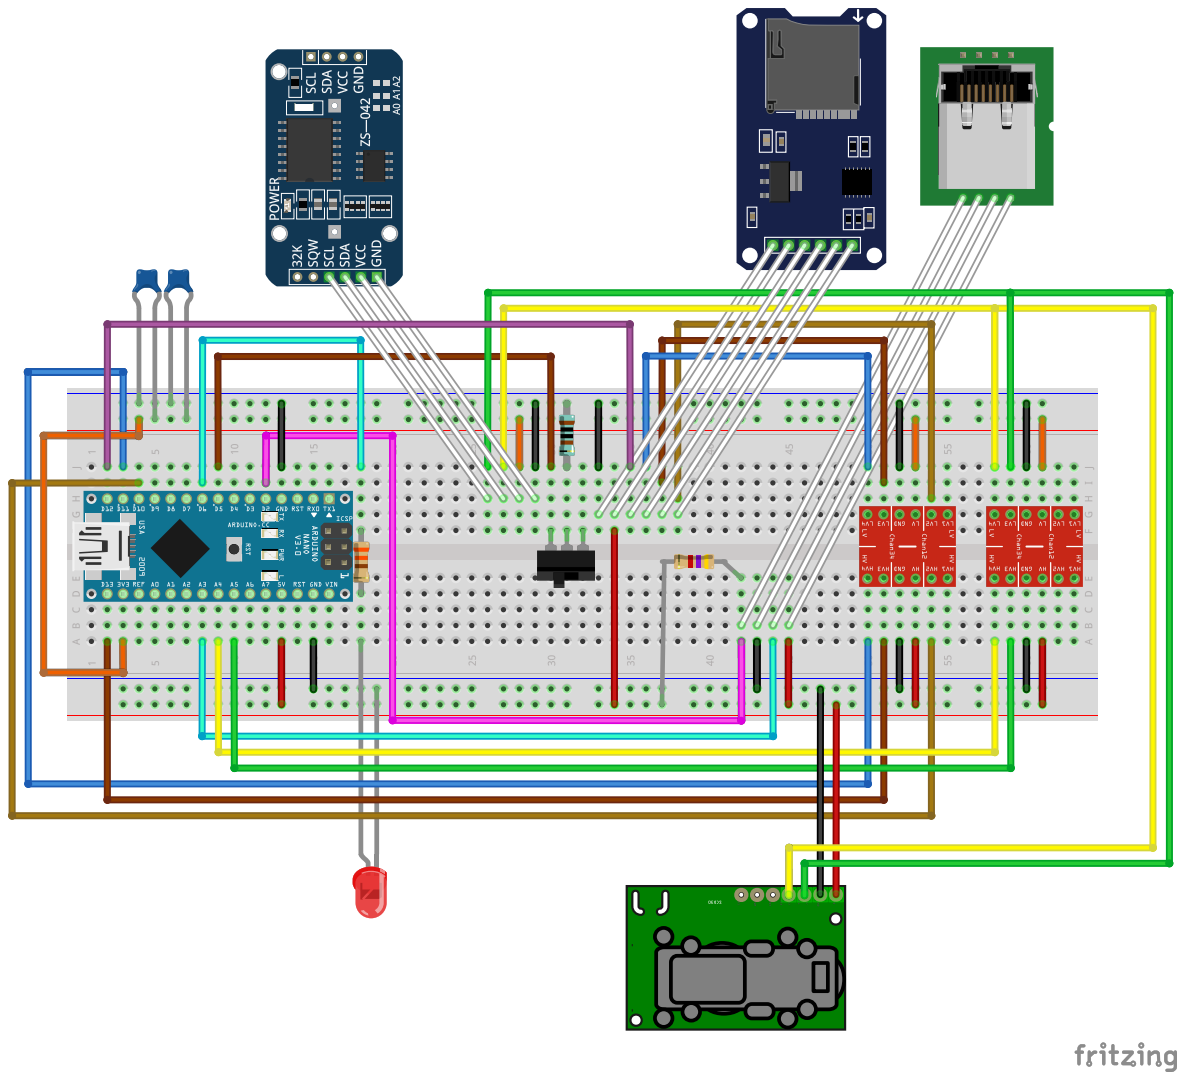
[picture p65: page 1]
