RiceAllDay22/WirelessSensorNetwork/Section1-Prototyping/SensorNode-ArduinoVersion/Schematics/ArduinoVersion_Schematic.pdf

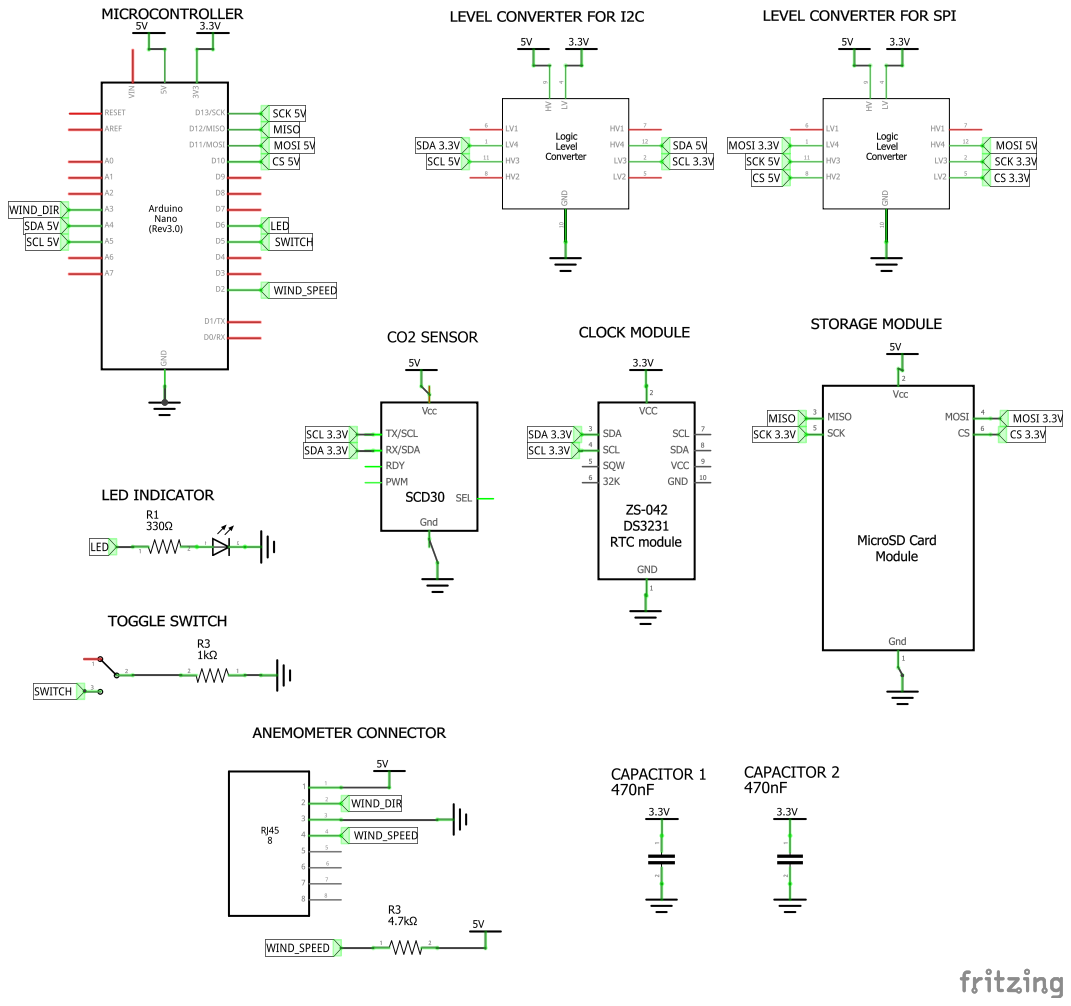
[picture p66: page 1]
