RiceAllDay22/WirelessSensorNetwork/Analysis/Collection/Node/Hardware/Node.brd

## EAGLE design UnusedFiles/JacobFiles/Hardware/Node.brd (2021-05-03, an earlier design)

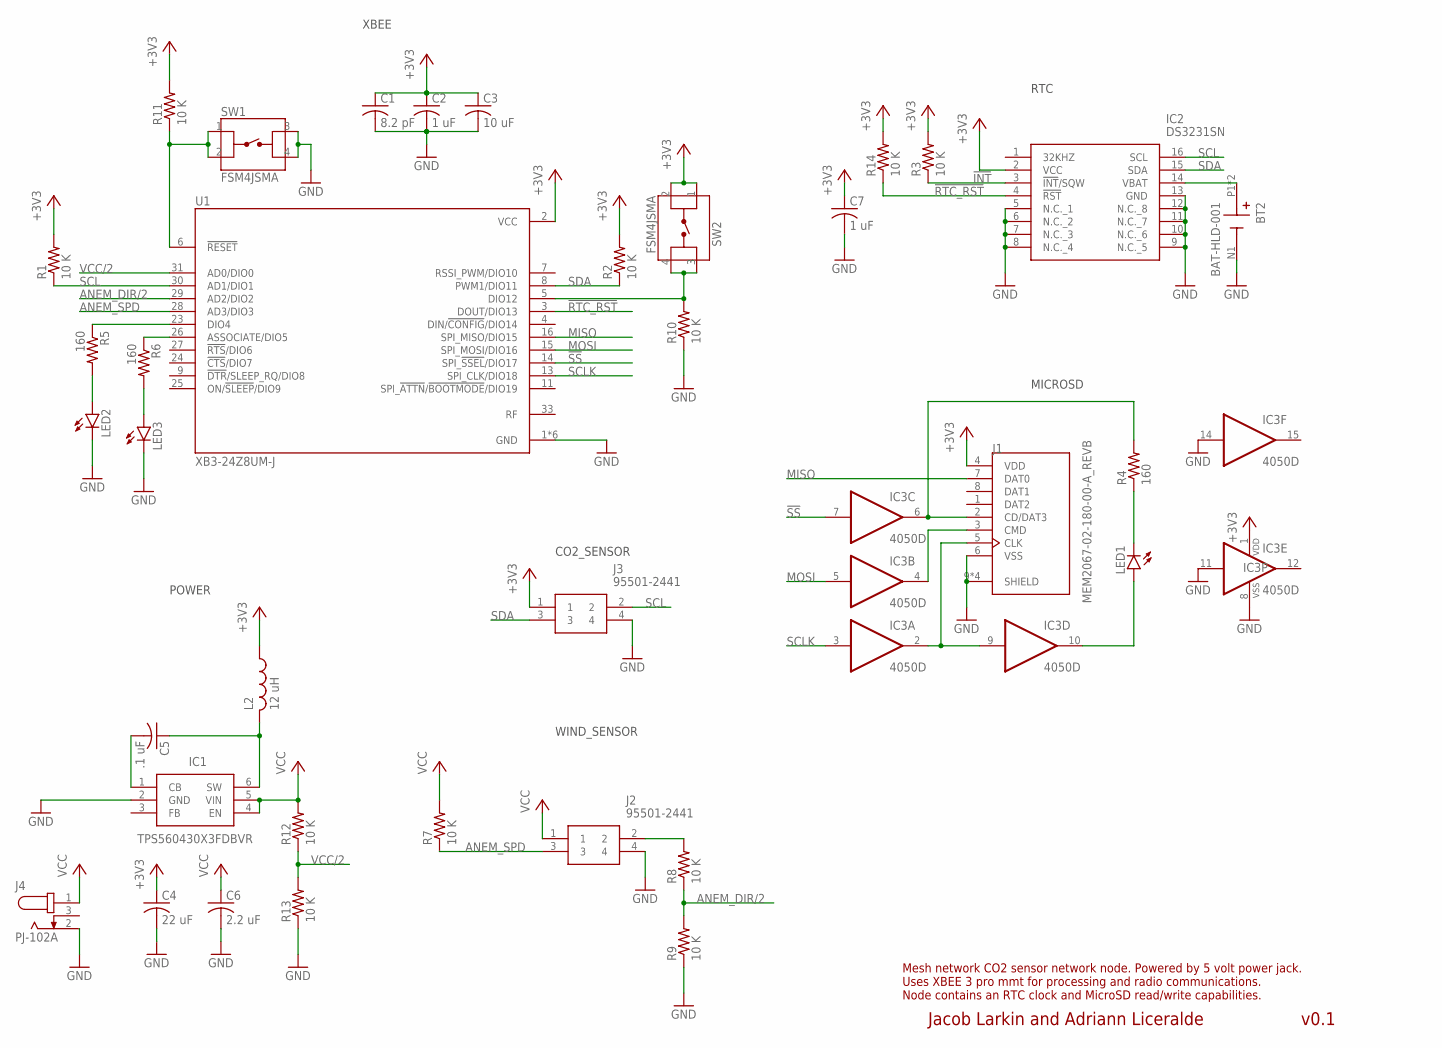
[picture p67: schematic Node.sch]

Parts:
BT2: BAT-HLD-001; BAT_BAT-HLD-001; MOUSER_NUM 712-BAT-HLD-001
C1: 8.2 pF; C0805; MOUSER_NUM 77-VJ0805A8R2BXXPBC
C2, C7: 1 uF; C0805; MOUSER_NUM 187-CL21B105KBFNNNG
C3: 10 uF; C0805; MOUSER_NUM 187-CL21A106KOQNNNG
C4: 22 uF; C0805; MOUSER_NUM 187-CL21A226MPQNNNE
C5: .1 uF; C0805; MOUSER_NUM 187-CL21B104KBCNNNC
C6: 2.2 uF; C0805; MOUSER_NUM 187-CL21A225KAFNNNE
IC1: TPS560430X3FDBVR; SOT95P280X145-6N; MOUSER_NUM 595-TPS560430X3FDBVR
IC2: DS3231SN; SOIC127P1032X265-16N; MOUSER_NUM 700-DS3231SN#T&R-
IC3: 4050D; SO16; MOUSER_NUM 771-74HC4050D-T
J1: MEM2067-02-180-00-A_REVB; GCT_MEM2067-02-180-00-A_REVB; DIGI-KEY_NUM 2073-MEM2067-02-180-00-ATR-ND
J2, J3: 95501-2441; 955012441; MOUSER_NUM 538-95501-2441
J4: PJ-102A; CUI_PJ-102A; MOUSER_NUM 490-PJ-102A
L2: 12 uH; L1812; MOUSER_NUM 652-CM453232-120KL
LED1, LED2, LED3: LEDCHIP-LED0805; CHIP-LED0805; MOUSER_NUM 720-LGR971-KN-1
R1, R2, R3, R7, R8, R9, R10, R11, R12, R13, R14: 10 K; R0805; MOUSER_NUM 660-RK73H2ATTD1002F
R4, R5, R6: 160; R0805; MOUSER_NUM 660-RK73H2ATTD1600F
SW1, SW2: FSM4JSMA; MOUSER_NUM 506-FSM4JSMA
U1: XB3-24Z8UM-J; XCVR_XB3-24Z8UM-J; MOUSER_NUM 888-XB3-24Z8UM

Connections:
!INT: IC2.3 (!INT!/SQW), R3.1
!RTC_RST: IC2.4 (!RST), R14.1, U1.3 (DOUT/DIO13)
!SS: IC3.7 (I), U1.14 (SPI_!SSEL!/DIO17)
+3V3: C1.1, C2.1, C3.1, C4.1, C7.1, IC2.2 (VCC), IC3.1 (VDD), J1.4 (VDD), J3.1, L2.1, R1.2, R2.2, R3.2, R11.2, R14.2, SW2.1, SW2.2, U1.2 (VCC)
ANEM_DIR: J2.2, R8.2
ANEM_DIR/2: R8.1, R9.2, U1.29 (AD2/DIO2)
ANEM_SPD: J2.3, R7.1, U1.28 (AD3/DIO3)
GND: BT2.N1 (-), C1.2, C2.2, C3.2, C4.2, C6.2, C7.2, IC1.2 (GND), IC2.5 (N.C._1), IC2.6 (N.C._2), IC2.7 (N.C._3), IC2.8 (N.C._4), IC2.9 (N.C._5), IC2.10 (N.C._6), IC2.11 (N.C._7), IC2.12 (N.C._8), IC2.13 (GND), IC3.8 (VSS), IC3.11 (I), IC3.14 (I), J1.6 (VSS), J1.9 (SHIELD), J1.10 (SHIELD), J1.11 (SHIELD), J1.12 (SHIELD), J2.4, J3.4, J4.2, LED2.C, LED3.C, R9.1, R10.1, R13.1, SW1.3, SW1.4, U1.1 (GND), U1.10 (GND), U1.12 (GND), U1.21 (GND), U1.32 (GND), U1.34 (GND)
MISO: J1.7 (DAT0), U1.16 (SPI_MISO/DIO15)
MOSI: IC3.5 (I), U1.15 (SPI_MOSI/DIO16)
unnamed: LED2.A, R5.2
unnamed: IC3.4 (O), J1.3 (CMD)
unnamed: C5.2, IC1.1 (CB)
unnamed: BT2.P1 (+), BT2.P2 (+), IC2.14 (VBAT)
unnamed: C5.1, IC1.6 (SW), L2.2
unnamed: IC3.6 (O), J1.2 (CD/DAT3), R4.2
unnamed: LED3.A, R6.2
unnamed: IC3.10 (O), LED1.A
unnamed: LED1.C, R4.1
unnamed: IC3.2 (O), IC3.9 (I), J1.5 (CLK)
unnamed: R5.1, U1.23 (DIO4)
unnamed: R6.1, U1.26 (ASSOCIATE/DIO5)
unnamed: R11.1, SW1.1, SW1.2, U1.6 (!RESET)
unnamed: R10.2, SW2.3, SW2.4, U1.5 (DIO12)
SCL: IC2.16 (SCL), J3.2, R1.1, U1.30 (AD1/DIO1)
SCLK: IC3.3 (I), U1.13 (SPI_CLK/DIO18)
SDA: IC2.15 (SDA), J3.3, R2.1, U1.8 (PWM1/DIO11)
VCC: C6.1, IC1.4 (EN), IC1.5 (VIN), J2.1, J4.1, R7.2, R12.2
VCC/2: R12.1, R13.2, U1.31 (AD0/DIO0)

Notes on the sheet:
Jacob Larkin and Adriann Liceralde
v0.1
Mesh network CO2 sensor network node. Powered by 5 volt power jack. Uses XBEE 3 pro mmt for processing and radio communications. Node contains an RTC clock and MicroSD read/write capabilities.
POWER
CO2_SENSOR
XBEE
RTC
MICROSD
WIND_SENSOR

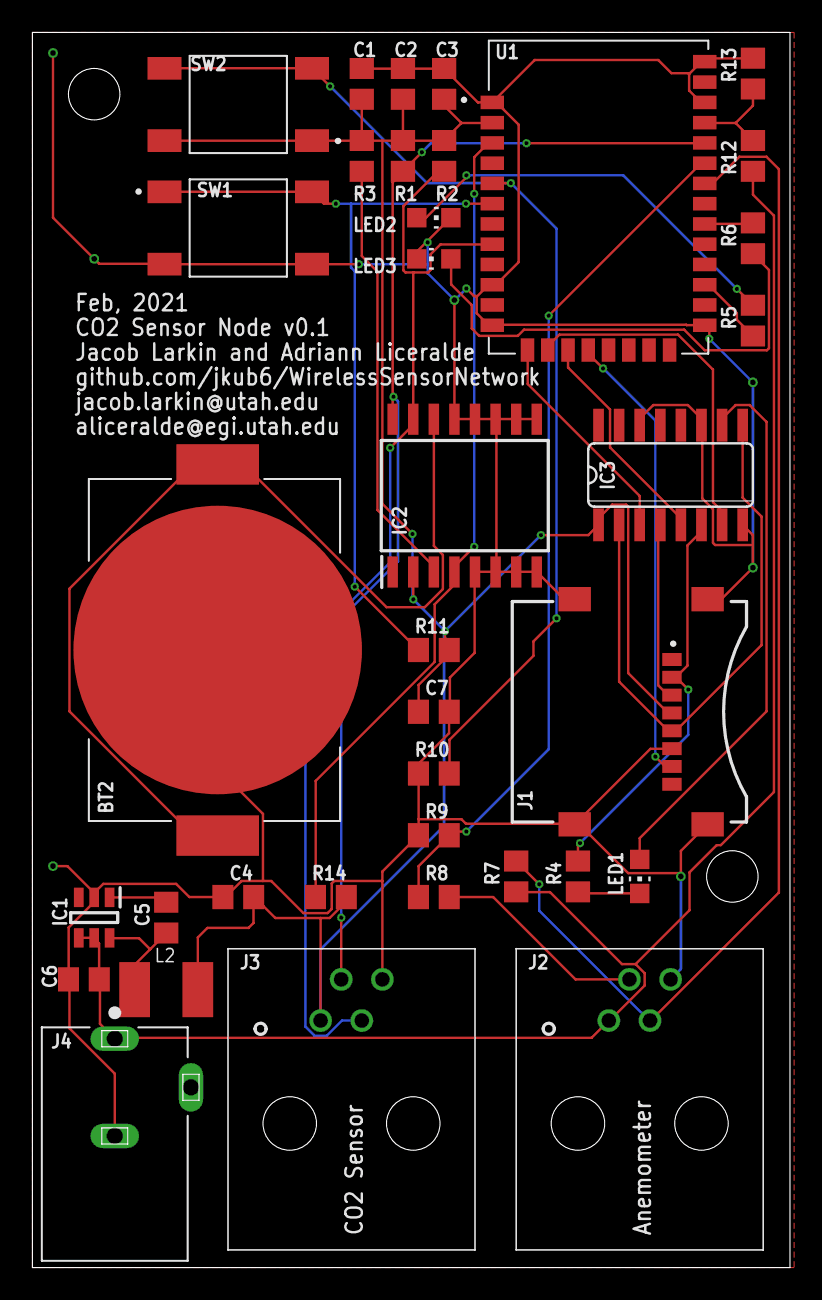
[picture p68: board Node.brd from above]

Board: 2 copper layers, 46.7 x 76.2 mm, 36 parts (0 on the bottom side), 29 nets.
