RiceAllDay22/WirelessSensorNetwork/Arduino/Program-ContinuousBeta13/Program-ContinuousBeta13.ino

//---------------LIBRARIES---------------//
//---------------------------------------//
#include <Wire.h>
#include <RTClib.h>
#include <SdFat.h>
#include <SparkFun_SCD30_Arduino_Library.h> 


//---------------VARIABLES---------------//
//---------------------------------------//
SdFat       sd;
SdFile      file;
RTC_DS3231  rtc;
DateTime    dt;
DateTime    filestart;
SCD30       airSensor;

const byte sdChipSelect = SS;
const byte WSPEED_PIN   = 2;
const byte DETACH_PIN   = 5;
const byte LED_PIN      = 6;

const int arrayLength = 5;  
uint32_t  unixTime[arrayLength];
uint8_t   windCyc[arrayLength];
uint16_t  windDir[arrayLength];
uint16_t  concData[arrayLength];
uint8_t   tempData[arrayLength];
uint16_t  scdData1;
uint8_t   scdData2;

bool wroteNewFile = true;
volatile byte windClicks  = 0;
volatile unsigned long lastWindIRQ = 0;

uint16_t VaneValue;
uint16_t Direction;
uint16_t CalDirection;
#define  Offset 0;  

uint32_t NodeID = 0;
void(* resetFunc)(void) = 0;                //declare reset function at address 0

//---------------SETUP-------------------//
//---------------------------------------//
void setup() {
  Serial.begin(9600);
  Serial.println("Setup Begin");
  
  Wire.begin();
  pinMode(LED_PIN,      OUTPUT);
  pinMode(WSPEED_PIN,   INPUT);
  pinMode(DETACH_PIN,   INPUT_PULLUP); 
  digitalWrite(LED_PIN, HIGH);

  RTCBegin();
  
  SCD30Begin();
  airSensor.setMeasurementInterval(2);                  // # seconds between readings
  airSensor.setAltitudeCompensation(1300);              // # meter above sea level
  
  SDBegin();
  dt = rtc.now();
  filestart = dt;
  CreateNewFile();
  delay(2000);
  
  attachInterrupt(digitalPinToInterrupt(WSPEED_PIN), isr_rotation, FALLING);
  interrupts();
 
  digitalWrite(LED_PIN, LOW);
  Serial.println("Setup Complete");
}


//--------------MAIN LOOP----------------//
//---------------------------------------//
void loop() {
  DateTime now_dt = rtc.now();
  
  for (int i=0; i<arrayLength; i++) {
    dt           = now_dt;
    unixTime[i]  = dt.unixtime();
    windDir[i]   = WindDirection(); 
    CollectGas();
    concData[i]  = scdData1;
    tempData[i]  = scdData2;

    do {
      now_dt = rtc.now();
    } while ( now_dt.unixtime() < dt.unixtime() + 3 );
    
    windCyc[i] = windClicks;
    windClicks = 0;
  }
  
  WriteSample();
  
  if (filestart.unixtime()+ 1200 <= dt.unixtime()) {
    filestart = dt;
    file.close();
    delay(5000);
    resetFunc();
  }
}   

//-------------FILE HANDLING-------------//
//---------------------------------------//
void CreateNewFile() {
  if (digitalRead(DETACH_PIN)) {
    Serial.println("DETATCH_PIN HIGH");
    return;
  }
  //char filename[19];
  //sprintf(filename, "%04d-%02d-%02d--%02d.csv", dt.year(), dt.month(), dt.day(), dt.hour());
  char filename[22];
  sprintf(filename, "%04d-%02d-%02d--%02d-%02d.csv", dt.year(), dt.month(), dt.day(), dt.hour(), dt.minute());
  file.open(filename, O_CREAT|O_WRITE|O_APPEND);

  Serial.print("Node ID:");
  Serial.println(NodeID);
  
  uint16_t settingVal;
  airSensor.getForcedRecalibration(&settingVal);
  Serial.print("Forced recalibration factor (ppm) is ");
  Serial.println(settingVal);

  uint8_t autoCalib = airSensor.getAutoSelfCalibration(); 
  Serial.print("Auto calibration set to ");
  Serial.println(autoCalib);

  uint16_t fillerOne = 0;
  uint8_t  fillerTwo = 0;
  
  file.write((NodeID      >> 24) & 0xFF);
  file.write((NodeID      >> 16) & 0xFF);
  file.write((NodeID      >> 8)  & 0xFF);
  file.write((NodeID      >> 0)  & 0xFF);
  file.write((autoCalib   >> 0)  & 0xFF);
  file.write((settingVal  >> 8)  & 0xFF);
  file.write((settingVal  >> 0)  & 0xFF);
  file.write((fillerOne   >> 8)  & 0xFF);
  file.write((fillerOne   >> 0)  & 0xFF);
  file.write((fillerTwo   >> 0)  & 0xFF);
  
  delay(1000);
  file.sync();
  Serial.println("Created new file.");
}

void WriteSample() {  
  if (digitalRead(DETACH_PIN)) {
    Serial.println("File Closed: (DETATCH_PIN HIGH)");
    digitalWrite(LED_PIN, HIGH);
    file.close();
    return;
  }

  else {
    digitalWrite(LED_PIN, HIGH);
  
    for (int j=0; j<arrayLength; j++) {
      file.write((unixTime[j] >> 24) & 0xFF);
      file.write((unixTime[j] >> 16) & 0xFF);
      file.write((unixTime[j] >> 8)  & 0xFF);
      file.write((unixTime[j] >> 0)  & 0xFF);
      file.write((windCyc[j]  >> 0)  & 0xFF);
      file.write((windDir[j]  >> 8)  & 0xFF);
      file.write((windDir[j]  >> 0)  & 0xFF);
      file.write((concData[j] >> 8)  & 0xFF);
      file.write((concData[j] >> 0)  & 0xFF);
      file.write((tempData[j] >> 0)  & 0xFF);
    }
    
    file.sync();
    digitalWrite(LED_PIN, LOW);
  }
}


//--------DATA RETRIEVAL FUNCTIONS-------//
//---------------------------------------//

//------Retrieve Conc and Temp Data------//
void CollectGas() {
  if (airSensor.dataAvailable()) {
    scdData1 = airSensor.getCO2();
    scdData2 = airSensor.getTemperature();
  }
  else {
    delay(5);
    if (airSensor.dataAvailable()) {
      scdData1 = airSensor.getCO2();
      scdData2 = airSensor.getTemperature();
    }
    else {
      scdData1 = 0;
      scdData2 = 0;
    }  
  }
}

//----------Retrieve Wind Speed----------//
void isr_rotation() {
  if ((unsigned long)( millis() - lastWindIRQ) > 15 ) {
    lastWindIRQ = millis(); 
    windClicks++;           
  }
}


//--------Retrieve Wind Direction-------//
uint16_t WindDirection() {
  VaneValue    = analogRead(A3);
  Direction    = map(VaneValue, 0, 1023, 1, 360);
  CalDirection = Direction + Offset;

  if (CalDirection > 360)
    CalDirection = CalDirection - 360;
  if (CalDirection < 1)
    CalDirection = CalDirection + 360;
  return (CalDirection);
}


//----------STARTUP MODULES---------------//
//---------------------------------------//

//----------RTC Begin----------//
void RTCBegin() {
  bool success = false;
  while (success == false) {
    if(rtc.begin()) {
      success = true;
    }
    else {
      Serial.println("RTC Failed");
    }
    delay(2000);
  }
  Serial.println("RTC Operational");
}


//----------Gas Begin----------//
void SCD30Begin() {
  bool success = false;
  while (success == false) {
    if(airSensor.begin(Wire, false, true)) {
      success = true;
      }      
    else {
      Serial.println("Sensor Failed");
    }
    delay(2000); 
  }
  Serial.println("Sensor Operational");
}


//----------SD Module Begin ----------//
void SDBegin() {
  bool success = false;
  while (success == false) {
    if(sd.begin(sdChipSelect)) {
      success = true; 
    }
    else {
      Serial.println("SD Module Failed");
    }
    delay(2000);
  }
  Serial.println("SD Module Operational");
}
