RiceAllDay22/WirelessSensorNetwork/Analysis/Collection/Node/Software/include/sdcard_controller.h

/*SD Card Controller.

This file defines a SDCardController class that provides access to SD Card functionality.

This file is a part of the Wireless Sensor Network project.
(c) Copyright 2020 Jacob Larkin and Adriann Liceralde
*/

#ifndef SDCARD_CONTROLLER_H
#define SDCARD_CONTROLLER_H

#include "SdFat.h"


enum class SDCardModes {
  FAKE_SERIAL,
  SD_FAT_CSV,
  SD_FAT_BINARY,
  NONE
};


class SDCardController {
    private:
        SDCardModes mode;
        SdFat sd;
        SdFile file;
        const uint8_t sdChipSelect = SS;
        int MAX_CONNECTION_ATTEMPTS = 10;
        int CONNECTION_ATTEMPT_DELAY = 1000;
    public:
        SDCardController(SDCardModes mode);
        bool begin();
        bool writeDataPoint(uint32_t unixtime, uint32_t gasData);
        bool createNewFile(char* filename);
        uint32_t checksum = 0;
        bool PRINT_TO_SERIAL = false;
        uint32_t fileSize();
};


#endif
