RiceAllDay22/WirelessSensorNetwork/Arduino/ModEx-Temp/ModEx-Temp.ino

#include <OneWire.h> 
#include <DallasTemperature.h>

#define ONE_WIRE_BUS 3
OneWire oneWire(ONE_WIRE_BUS); 
DallasTemperature sensors(&oneWire);

void setup() {
  Serial.begin(9600);
  sensors.begin();
}

void loop() {
  sensors.requestTemperatures();
  float value = sensors.getTempCByIndex(0);
  Serial.println(value);
  delay(1000);
}
