RiceAllDay22/WirelessSensorNetwork/Arduino/Program-XbeeB_V3/Program-XbeeB_V3.ino

//Arduino UNO XBee Receiver Code
#include <SoftwareSerial.h>

SoftwareSerial XBee(2, 3);
byte WIRE_PIN   = 11;
byte BUTTON_PIN = 12;
byte LED_PIN    = 5;
int value = 49;


void setup() {
  Serial.begin(9600); 
  Serial.println("Receiver");
  pinMode(2, INPUT);
  pinMode(3, OUTPUT);
  XBee.begin(9600);
  Serial.println("Flying is for droids.");
}

 
void loop() {
  while (XBee.available()){
    digitalWrite(LED_PIN, HIGH);
    char data = XBee.read();
    Serial.print(data);
  }
}
