RiceAllDay22/WirelessSensorNetwork/Pycharm/NodeCode/MainCode/sensirion.py

'''
    Source: https://github.com/agners/micropython-scd30/blob/master/scd30.py

    Edited by Adriann Liceralde
    6/20/2022
'''

import utime
import time
import struct

class SCD30:
    class NotFoundException(Exception):
        pass

    class CRCException(Exception):
        pass

    START_CONT_MEASURE = 0x0010
    STOP_CONT_MEASURE = 0x0104
    SET_MEASURE_INTERVAL = 0x4600
    GET_STATUS_READY = 0x0202
    READ_MEASUREMENT = 0x0300
    SET_ASC = 0x5306
    SET_FRC = 0x5204
    SET_TEMP_OFFSET = 0x5403
    SET_ALT_COMP = 0x5102
    GET_FIRMWARE_VER = 0xd100
    SOFT_RESET = 0xd304

    CLOCK_TIME_US = 10

    # Generated using
    # crc_table = []
    # for crc in range(256):
    #     for crc_bit in range(8):
    #         if crc & 0x80:
    #             crc = (crc << 1) ^ CRC8_POLYNOMIAL;
    #         else:
    #             crc = (crc << 1);
    #         crc = crc%256
    #     crc_table.append(crc)

    CRC_TABLE = [
        0, 49, 98, 83, 196, 245, 166, 151, 185, 136, 219, 234, 125, 76, 31, 46,
        67, 114, 33, 16, 135, 182, 229, 212, 250, 203, 152, 169, 62, 15, 92, 109,
        134, 183, 228, 213, 66, 115, 32, 17, 63, 14, 93, 108, 251, 202, 153, 168,
        197, 244, 167, 150, 1, 48, 99, 82, 124, 77, 30, 47, 184, 137, 218, 235,
        61, 12, 95, 110, 249, 200, 155, 170, 132, 181, 230, 215, 64, 113, 34, 19,
        126, 79, 28, 45, 186, 139, 216, 233, 199, 246, 165, 148, 3, 50, 97, 80,
        187, 138, 217, 232, 127, 78, 29, 44, 2, 51, 96, 81, 198, 247, 164, 149,
        248, 201, 154, 171, 60, 13, 94, 111, 65, 112, 35, 18, 133, 180, 231, 214,
        122, 75, 24, 41, 190, 143, 220, 237, 195, 242, 161, 144, 7, 54, 101, 84,
        57, 8, 91, 106, 253, 204, 159, 174, 128, 177, 226, 211, 68, 117, 38, 23,
        252, 205, 158, 175, 56, 9, 90, 107, 69, 116, 39, 22, 129, 176, 227, 210,
        191, 142, 221, 236, 123, 74, 25, 40, 6, 55, 100, 85, 194, 243, 160, 145,
        71, 118, 37, 20, 131, 178, 225, 208, 254, 207, 156, 173, 58, 11, 88, 105,
        4, 53, 102, 87, 192, 241, 162, 147, 189, 140, 223, 238, 121, 72, 27, 42,
        193, 240, 163, 146, 5, 52, 103, 86, 120, 73, 26, 43, 188, 141, 222, 239,
        130, 179, 224, 209, 70, 119, 36, 21, 59, 10, 89, 104, 255, 206, 157, 172
    ]

    def __init__(self, i2c, addr, pause=1000):
        print("SCD Initializing")
        success = 0
        while success == 0:
            devices = i2c.scan()
            self.i2c = i2c
            self.pause = pause
            self.addr = addr

            if addr in devices:
                success = 1
            else:
                print("Did not find SCD30")
                time.sleep(1)
                # raise self.NotFoundException


    def start_continous_measurement(self, ambient_pressure=0):
        bint = struct.pack('>H', ambient_pressure)
        crc = self.__crc(bint[0], bint[1])
        data = bint + bytes([crc])
        self.i2c.writeto_mem(self.addr, self.START_CONT_MEASURE, data, addrsize=16)

    def stop_continous_measurement(self):
        self.__write_command(self.STOP_CONT_MEASURE)

    def soft_reset(self):
        self.__write_command(self.SOFT_RESET)

    def get_firmware_version(self):
        ver = self.__read_bytes(self.GET_FIRMWARE_VER, 3)
        self.__check_crc(ver)
        return struct.unpack('BB', ver)

    def read_measurement(self):
        crc_fail = 0
        measurement = self.__read_bytes(self.READ_MEASUREMENT, 18)
        for i in range(0, len(measurement), 3):
            if self.__check_crc(measurement[i:i + 3]) == 0:
                print('check_crc failed at read_measurements')
                crc_fail = 1
                break

        if crc_fail == 0:
            value = measurement[0:]
            co2 = struct.unpack('>f', value[0:2] + value[3:5])[0]
            value = measurement[6:]
            temperature = struct.unpack('>f', value[0:2] + value[3:5])[0]
            value = measurement[12:]
            relh = struct.unpack('>f', value[0:2] + value[3:5])[0]
        else:
            co2, temperature, relh = 0, 0, 0

        return [co2, temperature, relh]
        #return (co2, temperature, relh) #This is the original line, which causes minor issues

    def get_status_ready(self):
        ready = self.__read_bytes(self.GET_STATUS_READY, 3)
        if self.__check_crc(ready) == 0:
            print('check_crc failed at get_status_ready')
        return struct.unpack('>H', ready)[0]

    def get_measurement_interval(self):
        bint = self.__read_bytes(self.SET_MEASURE_INTERVAL, 3)
        self.__check_crc(bint)
        return struct.unpack('>H', bint)[0]

    def set_measurement_interval(self, interval):
        bint = struct.pack('>H', interval)
        crc = self.__crc(bint[0], bint[1])
        data = bint + bytes([crc])
        self.i2c.writeto_mem(self.addr, self.SET_MEASURE_INTERVAL, data, addrsize=16)

    def get_automatic_recalibration(self):
        bint = self.__read_bytes(self.SET_ASC, 3)
        self.__check_crc(bint)
        return struct.unpack('>H', bint)[0] == 1

    def set_automatic_recalibration(self, enable):
        bint = struct.pack('>H', 1 if enable else 0)
        crc = self.__crc(bint[0], bint[1])
        data = bint + bytes([crc])
        self.i2c.writeto_mem(self.addr, self.SET_ASC, data, addrsize=16)
        #self.i2c.writeto_mem(self.addr, self.SET_FRC, data, addrsize=16) #This is the original line, which is an ERROR

    def get_forced_recalibration(self):
        bint = self.__read_bytes(self.SET_FRC, 3)
        self.__check_crc(bint)
        return struct.unpack('>H', bint)[0]

    def set_forced_recalibration(self, co2ppm):
        bint = struct.pack('>H', co2ppm)
        crc = self.__crc(bint[0], bint[1])
        data = bint + bytes([crc])
        self.i2c.writeto_mem(self.addr, self.SET_FRC, data, addrsize=16)

    def get_temperature_offset(self):
        bint = self.__read_bytes(self.SET_TEMP_OFFSET, 3)
        self.__check_crc(bint)
        return struct.unpack('>H', bint)[0] / 100.0

    def set_temperature_offset(self, offset):
        bint = struct.pack('>H', int(offset * 100))
        crc = self.__crc(bint[0], bint[1])
        data = bint + bytes([crc])
        self.i2c.writeto_mem(self.addr, self.SET_TEMP_OFFSET, data, addrsize=16)

    def get_altitude_comp(self):
        bint = self.__read_bytes(self.SET_ALT_COMP, 3)
        self.__check_crc(bint)
        return struct.unpack('>H', bint)[0]

    def set_altitude_comp(self, altitude):
        bint = struct.pack('>H', altitude)
        crc = self.__crc(bint[0], bint[1])
        data = bint + bytes([crc])
        self.i2c.writeto_mem(self.addr, self.SET_ALT_COMP, data, addrsize=16)

    def __write_command(self, cmd):
        bcmd = struct.pack('>H', cmd)
        self.i2c.writeto(self.addr, bcmd)

    def __read_bytes(self, cmd, count):
        self.__write_command(cmd)
        utime.sleep_us(self.pause)
        return self.i2c.readfrom(self.addr, count)

    # def __check_crc(self, arr):
    #     assert (len(arr) == 3)
    #     if self.__crc(arr[0], arr[1]) != arr[2]:
    #         raise self.CRCException

    def __check_crc(self, arr):
        assert (len(arr) == 3)
        if self.__crc(arr[0], arr[1]) != arr[2]:
            print('------------------------------------------------------------------------------')
            print('________________ERROR #12: CRC error__________________________________________')
            print('------------------------------------------------------------------------------')
            print(arr[0], arr[1], arr[2])
            return 0
        else:
            return 1


    def __crc(self, msb, lsb):
        crc = 0xff
        crc ^= msb
        crc = self.CRC_TABLE[crc]
        if lsb is not None:
            crc ^= lsb
            crc = self.CRC_TABLE[crc]
        return crc

    def getData(self):
        if self.get_status_ready() == 1:
            conc, temp, humid = self.read_measurement()

            if conc == 0 and temp == 0 and humid == 0:
                print('----------------First self.read_measurement() returned zeros------------------')
                time.sleep(1)
                conc, temp, humid = self.read_measurement()

            conc = int(conc)
            temp = int(temp)
            humid = int(humid)

        else:
            print('------------------------------------------------------------------------------')
            print('--------------------------------FIRST getData FAILED--------------------------------')
            print('------------------------------------------------------------------------------')
            time.sleep(1)
            if self.get_status_ready() == 1:
                conc, temp, humid = self.read_measurement()
                conc = int(conc)
                temp = int(temp)
                humid = int(humid)

            else:
                conc, temp, humid = 0, 0, 0
                print('------------------------------------------------------------------------------')
                print('--------------------------------SECOND getData FAILED--------------------------------')
                print('------------------------------------------------------------------------------')

        return [conc, temp, humid]
