RiceAllDay22/WirelessSensorNetwork/Arduino/Test-RTCRetrieve/Test-RTCRetrieve.ino

#include <RTClib.h>
RTC_DS3231 rtc;
DateTime dt;

void setup() {
  Serial.begin(9600);
  RTCBegin();
}

void loop() {
  dt = rtc.now(); 
  Serial.print(dt.year(), DEC);
  Serial.print('/');
  Serial.print(dt.month(), DEC);
  Serial.print('/');
  Serial.print(dt.day(), DEC);
  Serial.print(" ");
  Serial.print(dt.hour(), DEC);
  Serial.print(':');
  Serial.print(dt.minute(), DEC);
  Serial.print(':');
  Serial.print(dt.second(), DEC);
  Serial.println();
  while (rtc.now().unixtime() == dt.unixtime());  
}

void RTCBegin() {
  bool success = false;
  while (success == false) {
    if(rtc.begin())
      success = true;
    else
      Serial.println("RTC Failed");
    delay(1000);
  }
  Serial.println("RTC Operational");
}
