RiceAllDay22/WirelessSensorNetwork/(commit log)

2020-03-05 Started board schematic
    [Node.brd, Node.sch]
2020-03-05 Added basic schematic parts, restructured repository
    [Node.brd, Node.sch]
2020-03-05 Added reference material, touched up README, restructured directory layout
    [Adafruit DS3231 RTC Breakout.brd, Adafruit DS3231 RTC Breakout.sch, arduino_Uno_ref.brd, arduino_Uno_ref.sch, microsd.brd, microsd.sch]
2020-03-05 Added some connections to Node schematic
    [Node.brd, Node.sch]
2020-03-06 Organizating Folders
    [2020-03-01--18.csv, 2020-03-01--19.csv, 2020-03-01--20.csv, 2020-03-01--21.csv, 2020-03-01--22.csv, 2020-03-01--23.csv, 2020-03-02--00.csv, 2020-03-02--01.csv]
2020-03-08 Added data sets
    [12-17-19.xlsx, 12-18-19.xlsx, 12-18.5-19.xlsx, 12-18.7-19.xlsx, 12-19-19.xlsx, 12-21-19.xlsx, 12-21.1-19.xlsx, 12-31-19.xlsx]
2020-03-08 Added Bunch of Arduino Files
2020-03-09 Added new data and fixing Analyzer code
    [12-31-19.csv, 2020-03-04--08EDITED.csv, Month3Day7Hour19.csv, Month3Day7Hour20.csv, Month3Day7Hour21.csv, Month3Day7Hour22.csv, Month3Day7Hour23.csv, Month3Day8Hour0.csv]
2020-03-09 Updated schematic
    [Node.brd, Node.sch]
2020-03-10 Improved frame selector
    [2020-03-04--08EDITED.csv]
2020-03-11 Adjusted board size
    [Node.brd, Node.sch]
2020-03-22 Analyzer code update
    [2020-03-04--08EDITED.csv]
2020-03-22 Created ASCI Combiner
    [2020-03-04--04.csv, 2020-03-04--05.csv, 2020-03-04--06.csv, C-2020-03-04.csv]
2020-03-22 Combiner for both ASCI and Binary are operational
    [C-2020-03-01.csv]
2020-03-22 Analyzer optimization
    [2020-03-03--00.csv, 2020-03-03--01.csv, 2020-03-03--02.csv, 2020-03-03--03.csv, 2020-03-03--04.csv, 2020-03-03--05.csv, 2020-03-03--06.csv, 2020-03-03--07.csv]
2020-03-23 Analyzer step 2 for 3 node test
    [2020-03-03--00.csv, 2020-03-03--01.csv, 2020-03-03--02.csv, 2020-03-03--03.csv, 2020-03-03--04.csv, 2020-03-03--05.csv, 2020-03-03--06.csv, 2020-03-03--07.csv]
2020-03-25 Analyzer Step 2
    [P-001-2020-03-04.csv, P-002-2020-03-04.csv, P-003-2020-03-04.csv, TestRun.csv]
2020-03-27 Old data
    [Month3Day10Hour0.csv, Month3Day10Hour1.csv, Month3Day10Hour10.csv, Month3Day10Hour11.csv, Month3Day10Hour12.csv, Month3Day10Hour13.csv, Month3Day10Hour14.csv, Month3Day10Hour15.csv]
2020-04-09 testing new comp
    [C-001-2020-03-04.csv]
2020-04-09 Test pull
    [C-003-2020-03-04.csv]
2020-04-29 Remove Arduino
2020-04-29 Test Arduino Folder
2020-04-29 Change sketch using Arduino IDE
2020-04-29 Test Arduino IDE and Git together
2020-04-29 test arduino
2020-04-29 Added Arduino codes
2020-04-30 Add new data
    [2020-04-29--23.csv, 2020-04-30--00.csv, 2020-04-30--01.csv, 2020-04-30--02.csv, 2020-04-30--03.csv, 2020-04-30--04.csv, 2020-04-30--05.csv, 2020-04-30--06.csv]
2020-05-01 Test Binary Data
    [2020-04-30--07.csv, 2020-04-30--08.csv, 2020-04-30--09.csv, 2020-04-30--10.csv, 2020-04-30--11.csv, 2020-04-30--12.csv, 2020-04-30--13.csv, 2020-04-30--14.csv]
2020-05-01 Attempt binary
    [2020-04-30--08.csv, 2020-04-30--10.csv, C-2020-04-30.csv]
2020-05-02 New Arduino XBee Code that works
2020-05-08 test edit
    [12-17-19.xlsx]
2020-05-13 Restructured to allow support for packages, platformio, unit tests, libraries, spike directories, workspaces, and microcontroller simulation. Implemented CRC32 in C++ and Python
    [Adafruit DS3231 RTC Breakout.brd, Adafruit DS3231 RTC Breakout.sch, arduino_Uno_ref.brd, arduino_Uno_ref.sch, microsd.brd, microsd.sch]
2020-05-16 optimized storage, added c02 sensor
2020-05-18 added csv and binary capabilities to data_utils.py. Made many unit tests.
    [1_entry.csv, 2_entries.csv, 50_entries.csv, 5_entries.csv, bad_datatype.csv, decimal1.csv, decimal2.csv, descending.csv]
2020-05-20 added node output file merging and respective unit tests
    [2020-04-30--00.csv, 2020-04-30--01.csv, 2020-04-30--02.csv, 5_entries_hex.csv, node_info.csv]
2020-05-20 added shared-wheels folder to git
2020-05-21 added debugging print statment
2020-05-23 added valid and invalid unit tests for merge files
    [2020-01-01--00.csv, 2020-04-30--00.csv, 2020-04-30--01.csv, 2020-04-30--02.csv, node_info.csv]
2020-05-23 created test visualization python notebook
    [2020-01-01--00.csv, node_info.csv]
2020-05-25 added visualization tests
    [2020-01-01--00.csv, node_info.csv]
2020-06-11 USB Meter Logger
    [PowerData 6-10-2020 H11 - Edit.csv, PowerData 6-10-2020 H11.csv, PowerData 6-10-2020 H13 - Edit.csv, PowerData 6-10-2020 H13.csv]
2020-06-12 Added data
    [2020-06-06--.xlsx, 2020-06-10--11.csv, 2020-06-10--11B.csv, 2020-06-10--13.csv, 2020-06-10--13B.csv, 2020-06-11--10.csv, 2020-06-12--10.csv]
2020-06-17 USB Code
    [2020-04-30--00.csv, 2020-06-11--10.csv, 2020-06-12--10.csv, 2020-06-13--10.csv, Summary.xlsx]
2020-06-17 edit USB code
    [2020-06-14--10.csv, 2020-06-15--10.csv, 2020-06-15--23.csv, 2020-06-16--15.csv, 2020-06-16--20.csv]
2020-06-22 New data
    [2020-06-19--11.csv, 2020-06-19--14.csv, 2020-06-20--10.csv]
2020-06-23 Binary file complete
    [2020-06-22--08.csv, 2020-06-22--09.csv, 2020-06-22--10.csv, 2020-06-22--11.csv, 2020-06-22--12.csv, 2020-06-22--13.csv, 2020-06-22--14.csv, 2020-06-22--15.csv]
2020-06-24 Edit binary translater
    [2020-04-30--07.csv, 2020-04-30--08.csv, 2020-04-30--09.csv, 2020-04-30--10.csv, 2020-04-30--11.csv, 2020-04-30--12.csv, 2020-04-30--13.csv, 2020-04-30--14.csv]
2020-06-29 Power consumption stuff
2020-07-02 Edited something
    [2020-07-01--08.csv, 2020-07-01--09.csv, 2020-07-01--10.csv, 2020-07-01--11.csv, 2020-07-01--12.csv, 2020-07-01--13.csv, 2020-07-01--14.csv, 2020-07-01--15.csv]
2020-07-02 Edit Arduino test code
2020-07-03 Edit Analyzer
    [2020-07-01--08.csv, 2020-07-01--09.csv, 2020-07-01--10.csv, 2020-07-01--11.csv, 2020-07-01--12.csv, 2020-07-01--13.csv, 2020-07-01--14.csv, 2020-07-01--15.csv]
2020-07-06 Edit Continuous Code
    [2020-07-02--18.csv, 2020-07-03--10.csv, 2020-07-04--10.csv, 2020-07-04--10B.csv, C-2020-07-02.csv]
2020-07-07 wind code
    [2020-07-05--22.csv, 2020-07-05--23.csv, 2020-07-06--00.csv, 2020-07-06--01.csv, 2020-07-06--02.csv, 2020-07-06--03.csv, 2020-07-06--04.csv, 2020-07-06--05.csv]
2020-07-07 Add solar production data
    [2020-07-04--23.csv, 2020-07-06--12.csv, 2020-07-07--11.csv]
2020-07-08 Wind sensor code
2020-07-09 Fixed USBLogger code
    [2020-07-08--10.csv, 2020-07-08--13.csv]
2020-07-12 Added wind columns for analysis
    [2020-06-06--.xlsx, 2020-07-09--10.csv, 2020-07-10--10.csv, 2020-07-11--10.csv, 2020-07-11--23.csv, C-2020-07-11.csv]
2020-07-13 Continuous Code Version 4
    [2020-07-11--23.csv, 2020-07-12--19.csv, C-2020-07-11.csv, C-2020-07-12.csv]
2020-07-14 real data
    [2020-07-12--19.csv, 2020-07-13--10.csv, 2020-07-13--11.csv, 2020-07-13--12.csv, 2020-07-13--13.csv, 2020-07-13--14.csv, 2020-07-13--15.csv, 2020-07-13--16.csv]
2020-07-15 Added LCD to continuous 4
    [2019-08-16.csv, 2020-07-14--20.csv]
2020-07-21 Added RStudio Files
    [2020-07-15--16.csv, 2020-07-17--16.csv, C-2020-07-13.csv, C-2020-07-14.csv, example.csv]
2020-07-27 XBee One-way transmission
    [2020-07-15--16.csv, 2020-07-22--09.csv]
2020-08-11 Arduino XBee Test
    [PostFallsTest.csv]
2020-08-12 Arduino Xbee Decoder
2020-08-15 Misc organization
    [2020-07-29--01.csv, 2020-07-29--23.csv, 2020-08-04--11.csv, 2020-08-04--13.csv, 2020-08-05--21.csv, 2020-08-12--.xlsx, PostFallsTest.csv]
2021-01-31 File Reader
    [2021-01-26--23.csv, Node.brd, Node.sch, Parts&Cost.xlsx, User Library-keystone-PN3034.step]
2021-01-31 Add Lego Home Test Data
    [2021-01-26--23.csv, 2021-01-26--23a.xlsx, 2021-01-26--23b.xlsx, 2021-01-26--23c.xlsx, 2021-01-26--23d.xlsx, 2021-01-26--23e.xlsx, 2021-01-26--23f.xlsx, 2021-01-26--23g.xlsx]
2021-02-16 Redesigned Hardware
    [Node.brd, Node.f3d, Node.sch, Node_BOM.csv, Parts&Cost.xlsx, User Library-keystone-PN3034.step]
2021-02-18 Update File Reader
    [Frequency 2sec.csv, Frequency 3sec.csv, Frequency 5sec.csv]
2021-06-22 openair R
    [2020-08-31--09.csv, 2020-08-31--10.csv, 2020-08-31--11.csv, 2020-08-31--12.csv, 2020-08-31--13.csv, 2020-08-31--14.csv, 2020-08-31--21.csv, 2020-08-31--22.csv]
2021-06-23 openair setup for analyzing data
    [DataPart1.csv, DataPart1b.csv, DataPart2.csv, FuckYou.csv, FuckYou.xlsx, New.csv, ProcessedData.csv]
2021-06-24 openair analysis
    [DataFull.csv, DataPart1.csv, DataPart1b.csv, FuckYou.csv, FuckYou.xlsx, New.csv, ProcessedData.csv, ProcessedData2.csv]
2021-06-30 SCD30 Sensor Code
2021-06-30 Continus 11 added calibration
2021-07-04 PWM rough code for MH-Z16
    [Frequency 5sec.csv]
2021-07-12 Continuous Code Version 12
    [C-2021-07-06.csv, C-2021-07-06_Pri_For1.csv, C-2021-07-06_Pri_For2.csv, C-2021-07-06_Sec_For1.csv, C-2021-07-06_Sec_For2.csv, CC-2021-07-06.csv, ProcessedData_Pri.csv, S-2021-07-06-00.csv]
2021-07-12 Added Union Data
    [2021-07-09--17.csv, 2021-07-09--18.csv, 2021-07-09--19.csv, 2021-07-09--20.csv, 2021-07-09--21.csv, 2021-07-09--22.csv, 2021-07-09--23.csv, 2021-07-10--00.csv]
2021-07-13 NEw Binary Combine
    [C-2021-07-09New.csv]
2021-07-13 Binary Code and R Code
    [2021-07-06--00.csv, 2021-07-06--01.csv, 2021-07-06--20.csv, 2021-07-06--21.csv, 2021-07-06--22.csv, 2021-07-06--23.csv, 2021-07-07--00.csv, 2021-07-07--01.csv]
2021-07-16 Test Data
    [2021-07-16--19-06.csv, 2021-07-16--19-07.csv, 2021-07-16--19-08.csv, 2021-07-16--19-10.csv, 2021-07-16--19-11.csv, 2021-07-16--19-12.csv, 2021-07-16--19-13.csv, 2021-07-16--19-15.csv]
2021-07-16 continuous 12 Version B
    [2021-07-16--19-06.csv, 2021-07-16--19-07.csv, 2021-07-16--19-08.csv, 2021-07-16--19-10.csv, 2021-07-16--19-11.csv, 2021-07-16--19-12.csv, 2021-07-16--19-13.csv, 2021-07-16--19-15.csv]
2021-07-18 V2.6 Data
    [2021-07-12--17.csv, 2021-07-12--18.csv, 2021-07-12--19.csv, 2021-07-12--20.csv, 2021-07-12--21.csv, 2021-07-12--22.csv, 2021-07-12--23.csv, 2021-07-13--00.csv]
2021-08-07 New Node
    [2021-07-13--13.csv, 2021-07-13--14.csv, 2021-07-15--14.csv, 2021-08-07--06.csv, 2021-08-07--07.csv, 2021-08-07--09.csv, 2021-08-07--10.csv, 2021-08-07--11.csv]
2021-08-14 Digi and Arduino
    [2000-01-01--00-00.csv, 2000-01-01--00-02.csv, 2000-01-01--00-04.csv, 2000-01-01--00-06.csv, 2000-01-01--00-09.csv, 2000-01-01--00-11.csv, 2000-01-01--00-13.csv, 2000-01-01--00-15.csv]
2021-08-19 Union Roof Prep with enhanced Arduino Nodes
2021-08-20 8-19-21 Added Primary Node Data
    [2021-07-27--17.csv, 2021-07-27--18.csv, 2021-07-27--19.csv, 2021-07-27--20.csv, 2021-07-27--21.csv, 2021-07-27--22.csv, 2021-07-28--14.csv, 2021-07-30--10.csv]
2021-08-20 Added 8-19 Secondary Node's Data
    [2021-07-27--15.csv, 2021-07-27--16.csv, 2021-07-27--17.csv, 2021-07-27--18.csv, 2021-07-27--19.csv, 2021-07-27--20.csv, 2021-07-27--21.csv, 2021-07-27--22.csv]
2021-08-23 Data Processing
    [C-2021-07-09-Pri.csv, C-2021-07-12-Pri.csv, C-2021-07-17-Pri.csv, C-2021-07-27-Pri.csv, C-2021-07-27-Sec.csv]
2021-08-24 Data Analysis for Update
    [C-2021-07-06-Pri.csv, C-2021-07-06-Sec.csv, C-2021-07-09-Pri.csv, C-2021-07-09-Sec.csv, C-2021-07-12-Pri.csv, C-2021-07-12-Sec.csv, C-2021-07-17-Pri.csv, C-2021-07-17-Sec.csv]
2021-09-06 Arduino, PyCharm, etc.
    [2021-08-19--15.csv, 2021-08-19--16.csv, 2021-08-19--17.csv, 2021-08-19--18.csv, 2021-08-19--19.csv, 2021-08-19--20.csv, 2021-08-19--21.csv, 2021-08-19--22.csv]
2021-09-11 Import Digi Samples
2021-09-13 Watch Dog, More Sample Tests
2021-11-26 11-24 Lab Idle Data
    [2021-11-14--06-25.csv, 2021-11-14--06-26.csv, 2021-11-14--19-07.csv, 2021-11-14--19-10.csv, 2021-11-14--19-12.csv, 2021-11-14--19-13.csv, 2021-11-14--19-15.csv, 2021-11-14--19-18.csv]
2021-11-28 PyCharm Node Bytes Transmission
    [2021-11-14--06-25.csv, 2021-11-14--06-26.csv, 2021-11-14--19-07.csv, 2021-11-14--19-10.csv, 2021-11-14--19-12.csv, 2021-11-14--19-13.csv, 2021-11-14--19-15.csv, 2021-11-14--19-18.csv]
2022-01-04 File Transfer
    [1_entry.csv, 2020-01-01--00.csv, 2020-04-30--00.csv, 2020-04-30--01.csv, 2020-04-30--02.csv, 2020-07-15--16.csv, 2020-07-17--16.csv, 2020-07-22--09.csv]
2022-01-12 Organize Python
    [2021-11-14--19-20.csv, 2021-11-14--20-20.csv, 2021-11-14--21-20.csv, 2021-11-14--22-20.csv, 2021-11-14--23-20.csv, 2021-11-15--00-20.csv, 2021-11-15--00-53.csv, 2021-11-15--01-28.csv]
2022-01-15 Dual Serial Line for Central
    [2022-1-12-14-15.csv, 2022-1-12-14-21.csv, 2022-1-12-14-22.csv, 2022-1-12-14-24.csv]
2022-01-16 PyCharm Digi Fix Test
    [main.py]
2022-01-18 Reorganize Digi Samples
2022-01-20 PyCharm MainCode and FramStorage
    [2022-1-19--22-49.csv, 2022-1-19--7-10.csv, 2022-1-19--7-14.csv, 2022-1-19--7-23.csv, 2022-1-20--0-4.csv]
2022-01-22 Fram Code
    [2022-1-20--21-53.csv, 2022-1-20--5-32.csv, 2022-1-21--0-40.csv, 2022-1-21--1-29.csv, 2022-1-21--18-10.csv, 2022-1-21--18-4.csv]
2022-01-23 CU-1106 Analysis
    [Licor.csv, Licor.xlsx, Licor_Ordered.csv, New Microsoft Excel Worksheet.xlsx, Roof Experiment After 1040.xlsx, Roof Experiment From 0920_1040 - Copy.xlsx, Roof Experiment From 0920_1040.xlsx, Roof Experiment From 0920_1040_Alignment.xlsx]
2022-01-25 Fram Emergency
    [2022-1-25--6-13.csv, Lab_All_Data.csv, Lab_All_Data.xlsx, Licor_Ordered.csv, Licor_Raw.csv, New Microsoft Excel Worksheet.xlsx, Roof Experiment After 1040.xlsx, Roof Experiment From 0920_1040 - Copy.xlsx]
2022-01-27 Error Fixes
    [2022-1-19--22-49.csv, 2022-1-19--7-10.csv, 2022-1-19--7-14.csv, 2022-1-19--7-23.csv, 2022-1-20--0-4.csv, 2022-1-20--21-53.csv, 2022-1-20--5-32.csv, 2022-1-21--0-40.csv]
2022-02-03 OAT test
    [2022-1-31--1-7.csv, 2022-1-31--16-52.csv, 2022-2-1--18-37.csv]
2022-02-08 Restore Node Folder
    [Node.brd, Node.f3d, Node.sch, Node_BOM.csv]
2022-02-18 File Removal
    [2019-08-16.csv, 2020-07-05--22.csv, 2020-07-05--23.csv, 2020-07-06--00.csv, 2020-07-06--01.csv, 2020-07-06--02.csv, 2020-07-06--03.csv, 2020-07-06--04.csv]
2022-03-06 Reorganize Repo
    [C-2022-3-5--6-54.csv, C-2022-3-6--14-25.csv, Node.brd, Node.f3d, Node.sch, Node_BOM.csv]
2022-03-17 ArduinoVersion guide
2022-03-18 Organize Folders structure
    [ArduinoVersion-Fritzing.fzz]
2022-03-18 Completed ArduinoVersion SensorNode
    [ArduinoVersion-Fritzing.fzz]
2022-03-18 Transferred SCD30 Assessment Files
    [11-01-21_Trial1.csv, 11-01-21_Trial2.csv, Lab_10-26_analysis.xlsx, Lab_10-26_raw.csv, MultiSCD30.fzz]
2022-03-19 Completed and Transferred RTC Assessment
    [HourlyDrift.xlsx, MultiSCD30.fzz]
2022-03-20 Completed and Added CU1106 Assessment
    [Lab_All_Data.csv, Union_All_Data.csv]
2022-03-23 Completed and added PowerUsage
    [PowerUsage-ArduinoNode.csv, PowerUsage-ArduinoNode.xlsx, PowerUsage-XBeeNode.xlsx]
2022-04-19 CentralHub Code
    [C-2022-4-16--6-28.csv, C-2022-4-16--6-29.csv, C-2022-4-16--6-32.csv, C-2022-4-19--21-30.csv, C-2022-4-19--21-31.csv, C-2022-4-19--21-32.csv]
2022-06-22 Anti-error code in MainCode
    [C-2022-4-22--3-0.csv, C-2022-4-23--0-0.csv, C-2022-6-17--22-25.csv, C-2022-6-17--22-8.csv, C-2022-6-17--23-0.csv, C-2022-6-17--23-26.csv, C-2022-6-18--0-0.csv, C-2022-6-18--1-0.csv]
2022-06-23 Slight changes to MainCode
    [C-2022-6-22--22-27.csv, C-2022-6-22--23-0.csv, C-2022-6-23--0-0.csv, C-2022-6-23--1-0.csv, C-2022-6-23--2-0.csv, C-2022-6-23--3-0.csv]
